EridaniBrew/BrewSpinDome/Documentation/ScopeImages/Rotation Wiring/IMG_0878.JPG

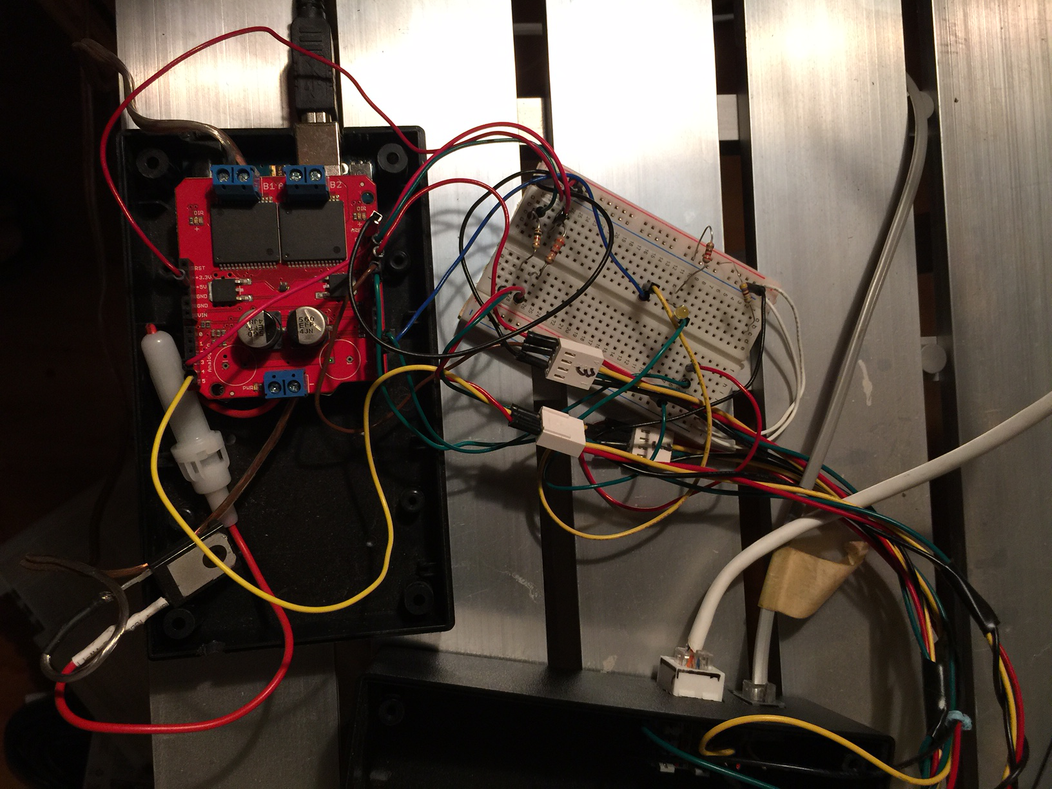
Documentation/ScopeImages/Rotation Wiring/IMG_0878.JPG
