EridaniBrew/BrewSpinDome/Documentation/ScopeImages/Rotation Wiring/IMG_0879.JPG

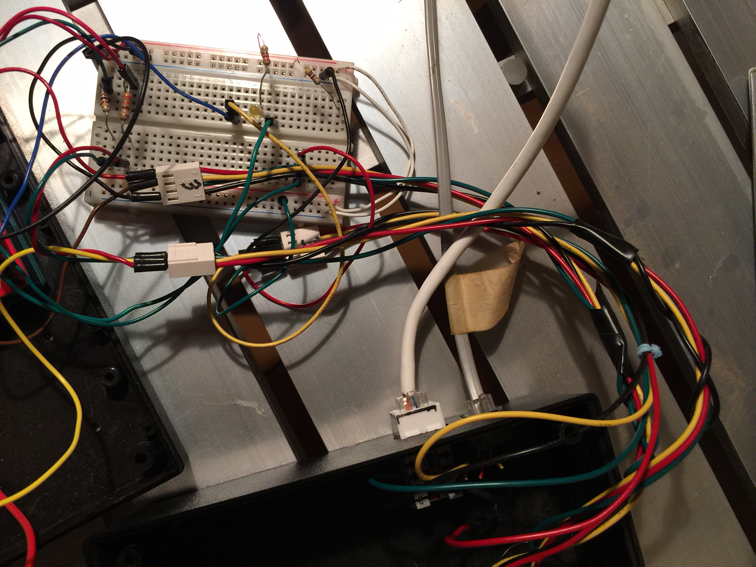
Documentation/ScopeImages/Rotation Wiring/IMG_0879.JPG
