EridaniBrew/BrewSpinDome/README.md

# BrewSpinDome
ASCOM SpinDome driver for Foster replacement system
