EridaniBrew/BrewSpinDome/ArduinoShutterControl/ShutterControlCover.jpg

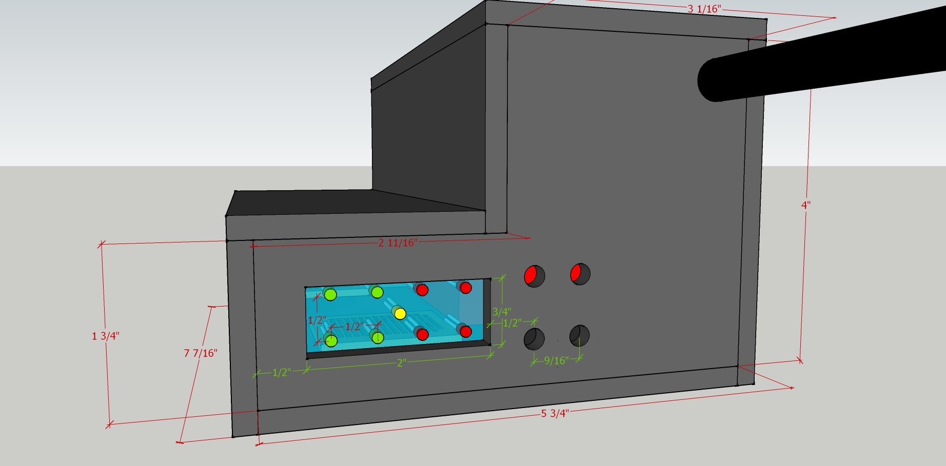
ArduinoShutterControl/ShutterControlCover.jpg
