EridaniBrew/BrewSpinDome/ArduinoShutterControl/ShutterControlSide1.jpg

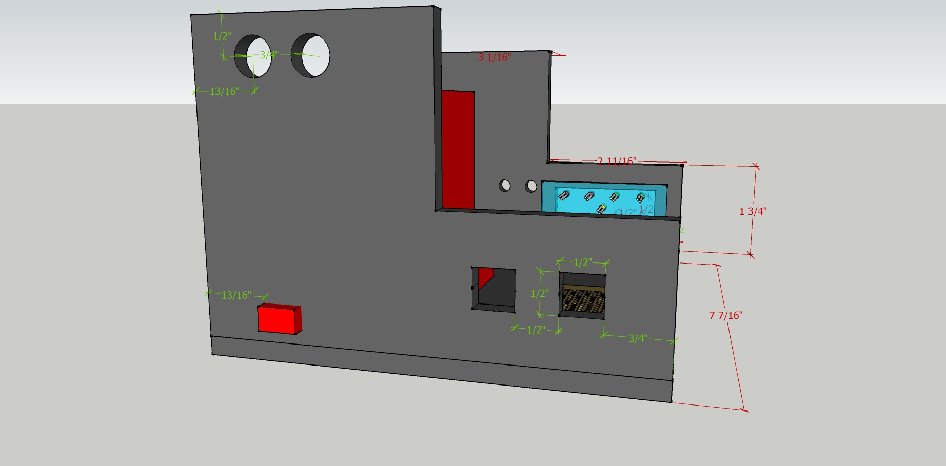
ArduinoShutterControl/ShutterControlSide1.jpg
