EridaniBrew/BrewSpinDome/ArduinoShutterControl/ShutterControlSide2.jpg

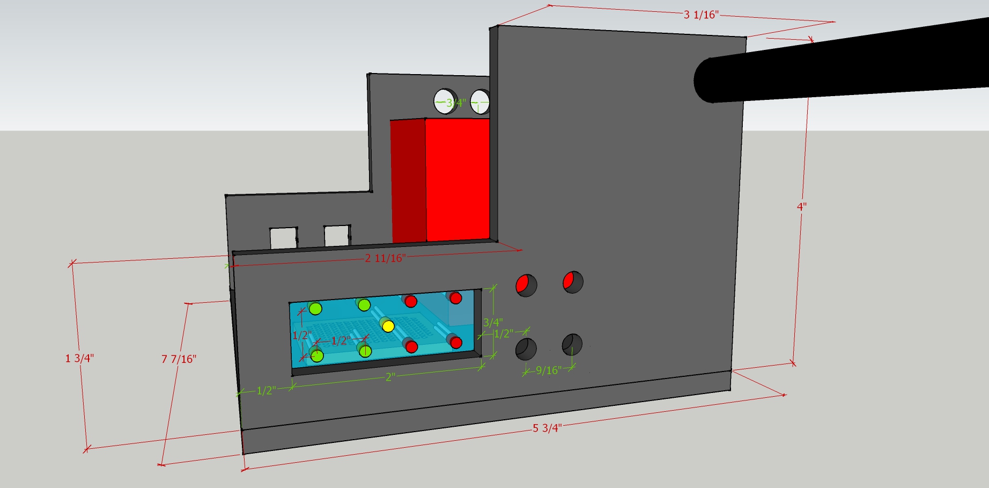
ArduinoShutterControl/ShutterControlSide2.jpg
