EridaniBrew/BrewSpinDome/ArduinoShutterControl/SmallPCB.png

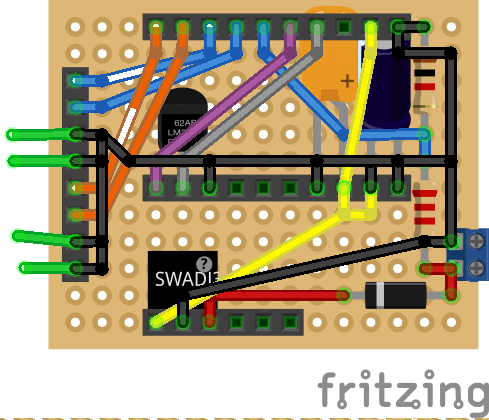
ArduinoShutterControl/SmallPCB.png
