EridaniBrew/BrewSpinDome/BrewSpinDome/BrewSpinControl/Resources/animdome.gif

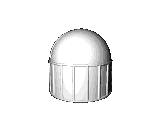
BrewSpinDome/BrewSpinControl/Resources/animdome.gif
