EridaniBrew/BrewSpinDome/BrewSpinDome/BrewSpinControl/Resources/blueLightOn.png

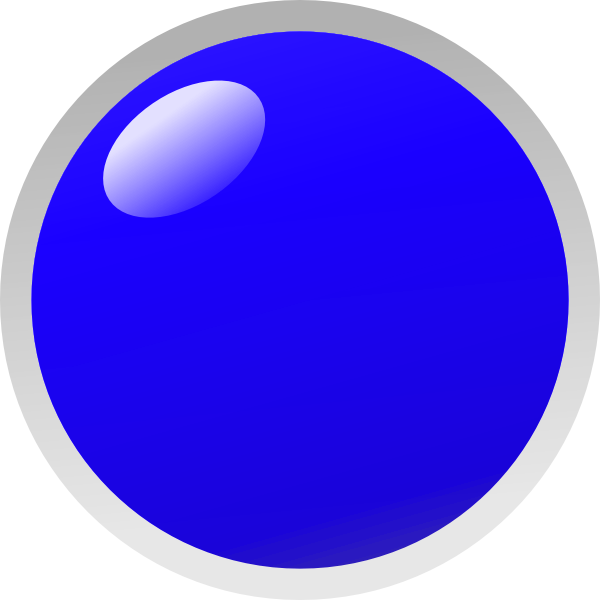
BrewSpinDome/BrewSpinControl/Resources/blueLightOn.png
