EridaniBrew/BrewSpinDome/BrewSpinDome/BrewSpinControl/Resources/Closed.png

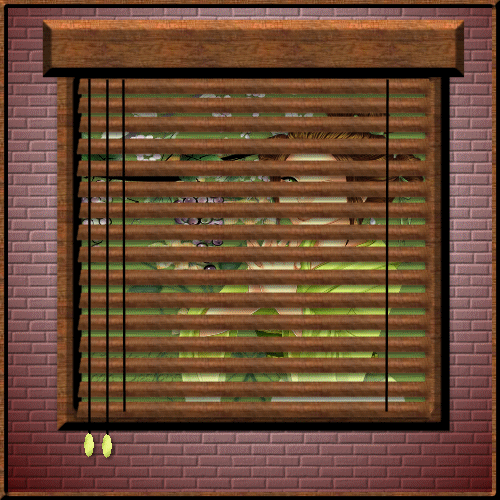
BrewSpinDome/BrewSpinControl/Resources/Closed.png
