EridaniBrew/BrewSpinDome/BrewSpinDome/BrewSpinControl/Resources/Closing.gif

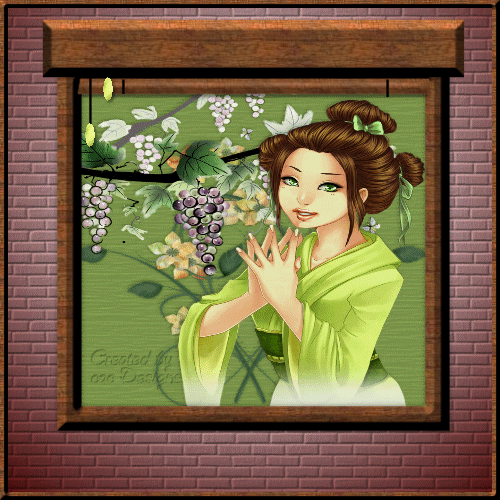
BrewSpinDome/BrewSpinControl/Resources/Closing.gif
