EridaniBrew/BrewSpinDome/BrewSpinDome/BrewSpinControl/Resources/loudlightning.gif

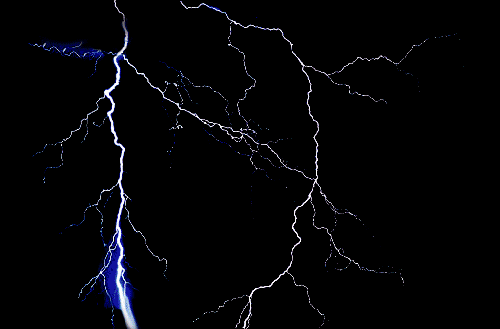
BrewSpinDome/BrewSpinControl/Resources/loudlightning.gif
