EridaniBrew/BrewSpinDome/BrewSpinDome/BrewSpinControl/Resources/quick.gif

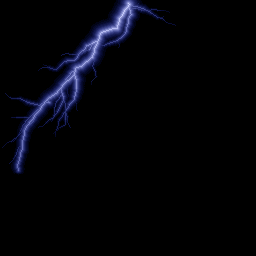
BrewSpinDome/BrewSpinControl/Resources/quick.gif
