EridaniBrew/BrewSpinDome/BrewSpinDome/BrewSpinControl/Resources/yellowLightOn.png

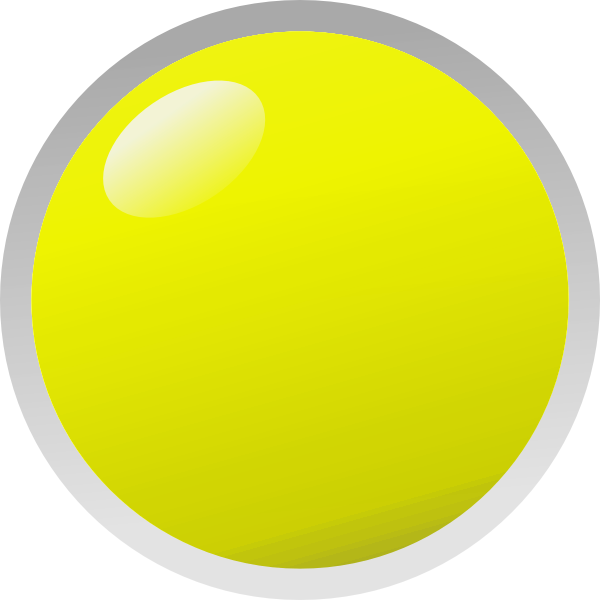
BrewSpinDome/BrewSpinControl/Resources/yellowLightOn.png
