EridaniBrew/BrewSpinDome/BrewSpinDome/SimpleShutter/Doc/Ard1.jpg

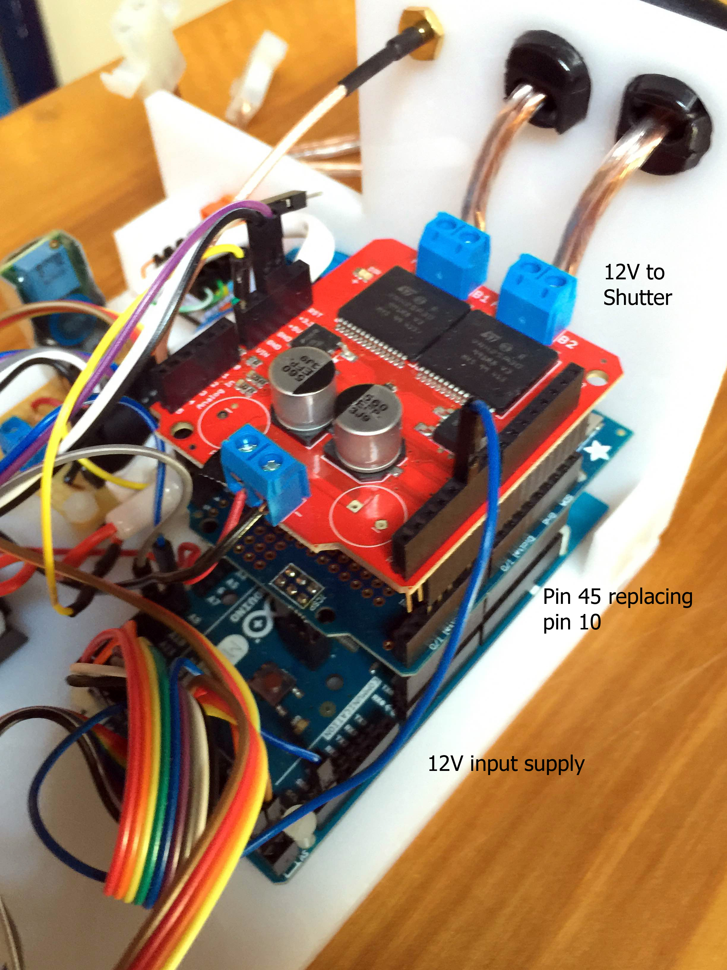
BrewSpinDome/SimpleShutter/Doc/Ard1.jpg
