EridaniBrew/BrewSpinDome/BrewSpinDome/SimpleShutter/Doc/DomeMount.jpg

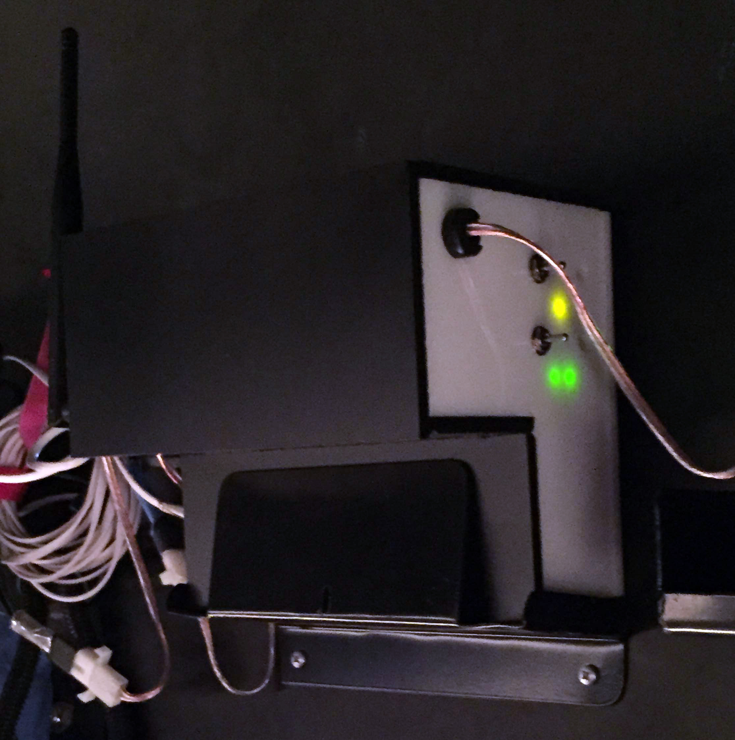
BrewSpinDome/SimpleShutter/Doc/DomeMount.jpg
