EridaniBrew/BrewSpinDome/BrewSpinDome/SimpleShutter/Doc/IMG_0030.JPG

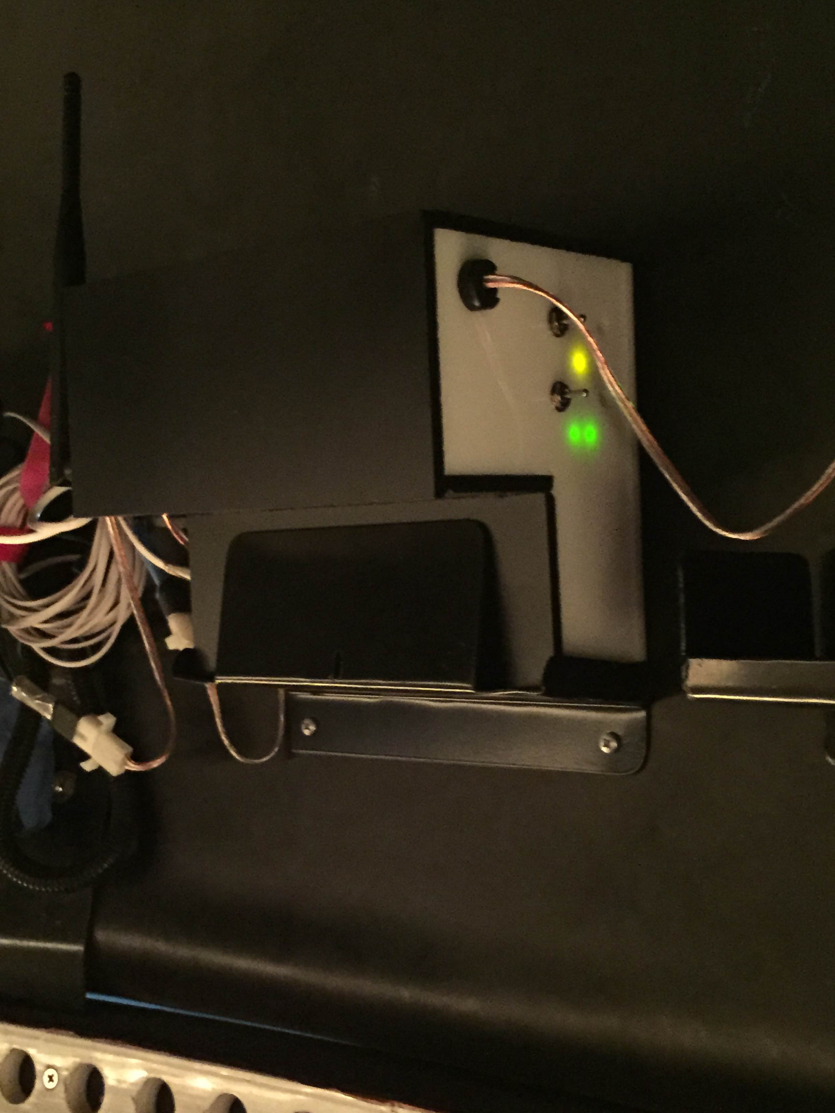
BrewSpinDome/SimpleShutter/Doc/IMG_0030.JPG
