EridaniBrew/BrewSpinDome/BrewSpinDome/SimpleShutter/Doc/IMG_0031.JPG

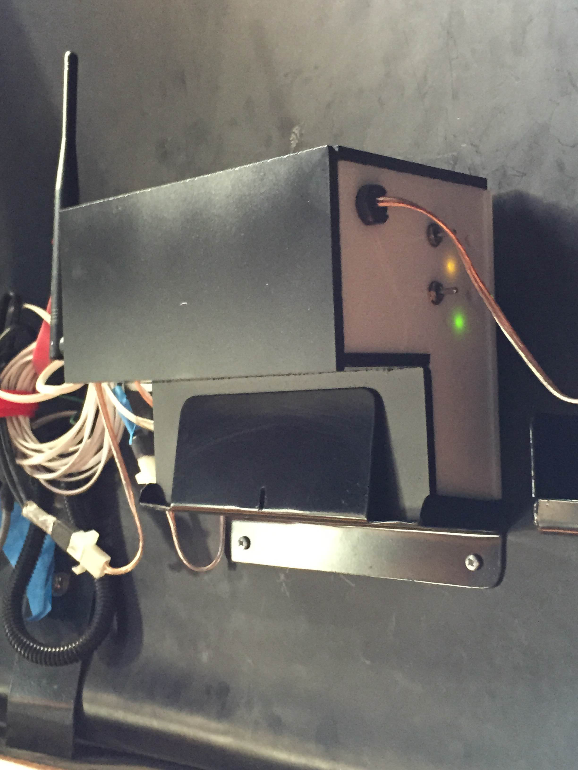
BrewSpinDome/SimpleShutter/Doc/IMG_0031.JPG
