EridaniBrew/BrewSpinDome/BrewSpinDome/SimpleShutter/Doc/IMG_0032.JPG

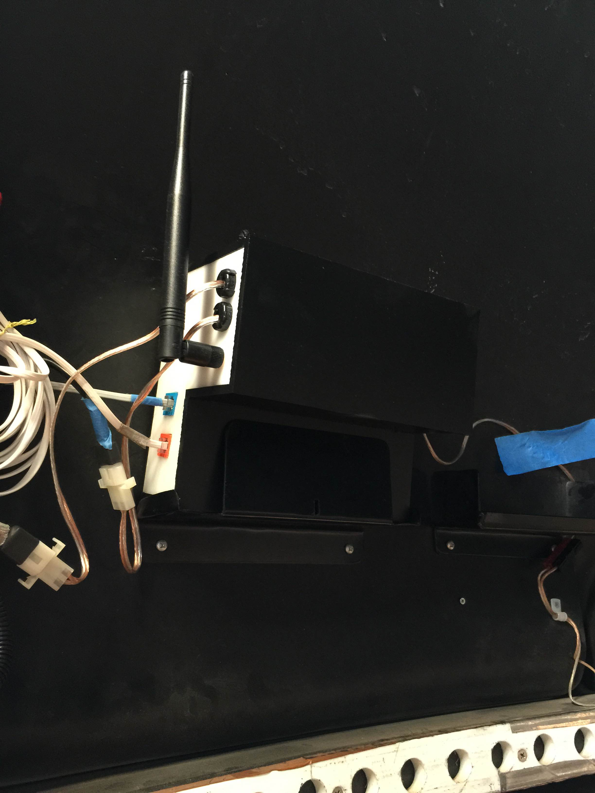
BrewSpinDome/SimpleShutter/Doc/IMG_0032.JPG
