EridaniBrew/BrewSpinDome/BrewSpinDome/SimpleShutter/Doc/IMG_0033.JPG

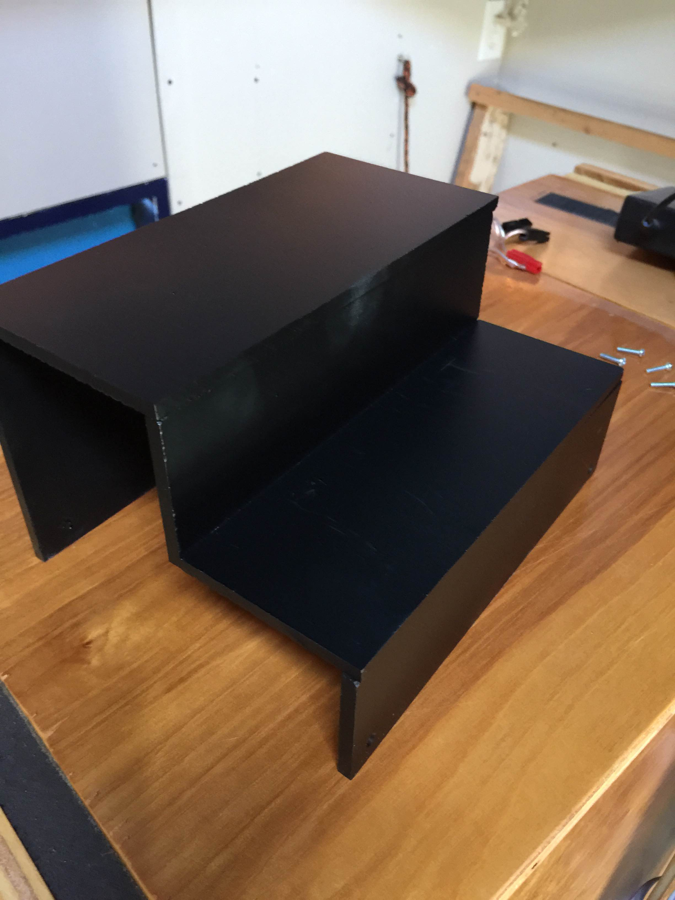
BrewSpinDome/SimpleShutter/Doc/IMG_0033.JPG
