EridaniBrew/BrewSpinDome/BrewSpinDome/SimpleShutter/Doc/IMG_0034.JPG

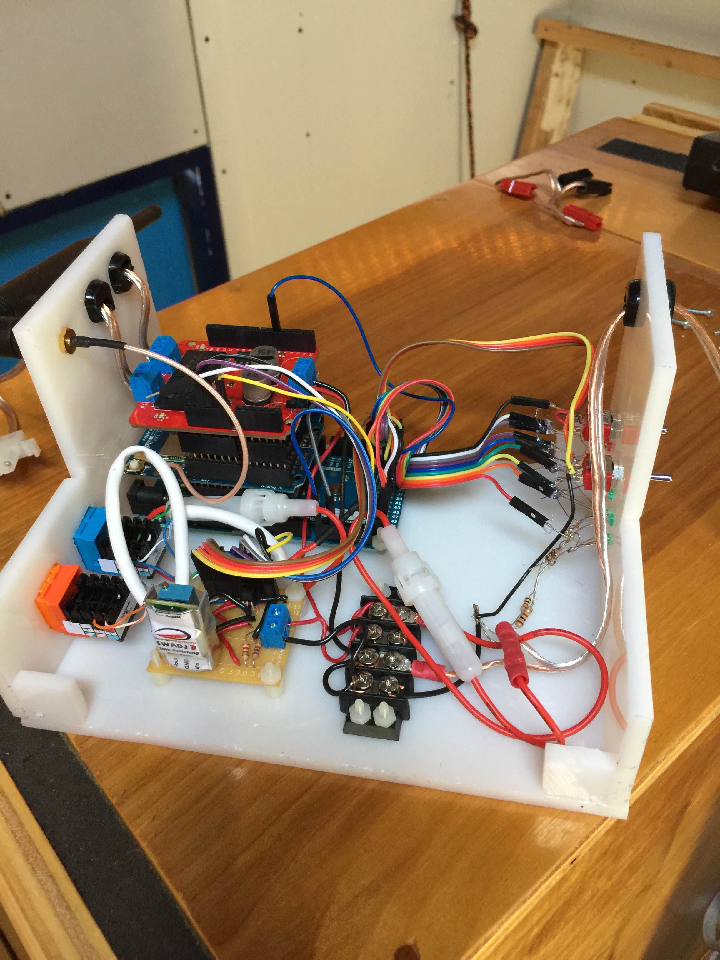
BrewSpinDome/SimpleShutter/Doc/IMG_0034.JPG
