EridaniBrew/BrewSpinDome/BrewSpinDome/SimpleShutter/Doc/IMG_0035.JPG

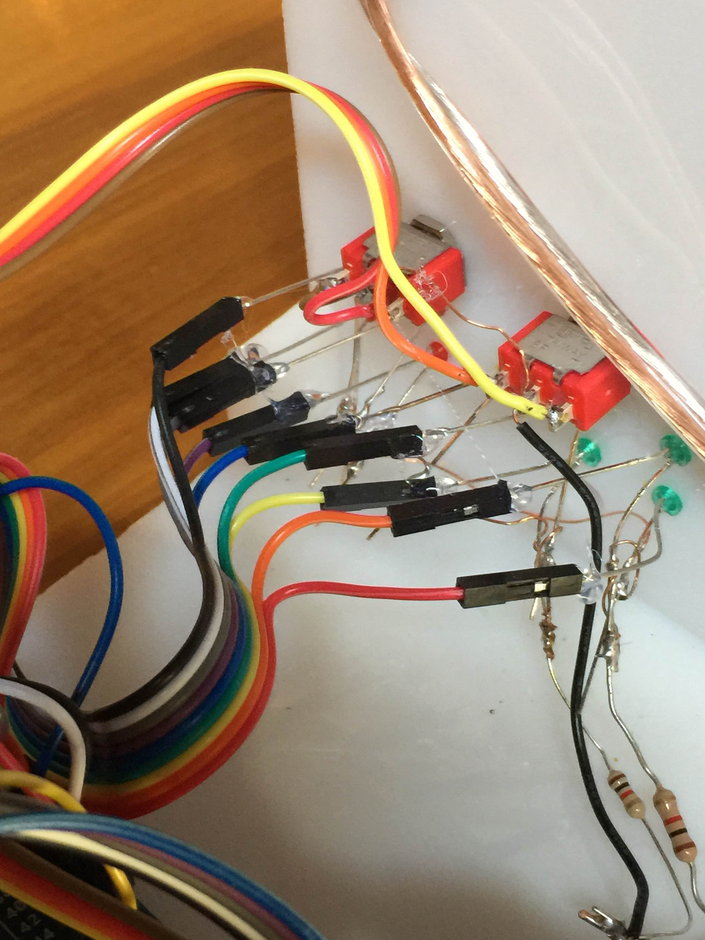
BrewSpinDome/SimpleShutter/Doc/IMG_0035.JPG
