EridaniBrew/BrewSpinDome/BrewSpinDome/SimpleShutter/Doc/IMG_0036.JPG

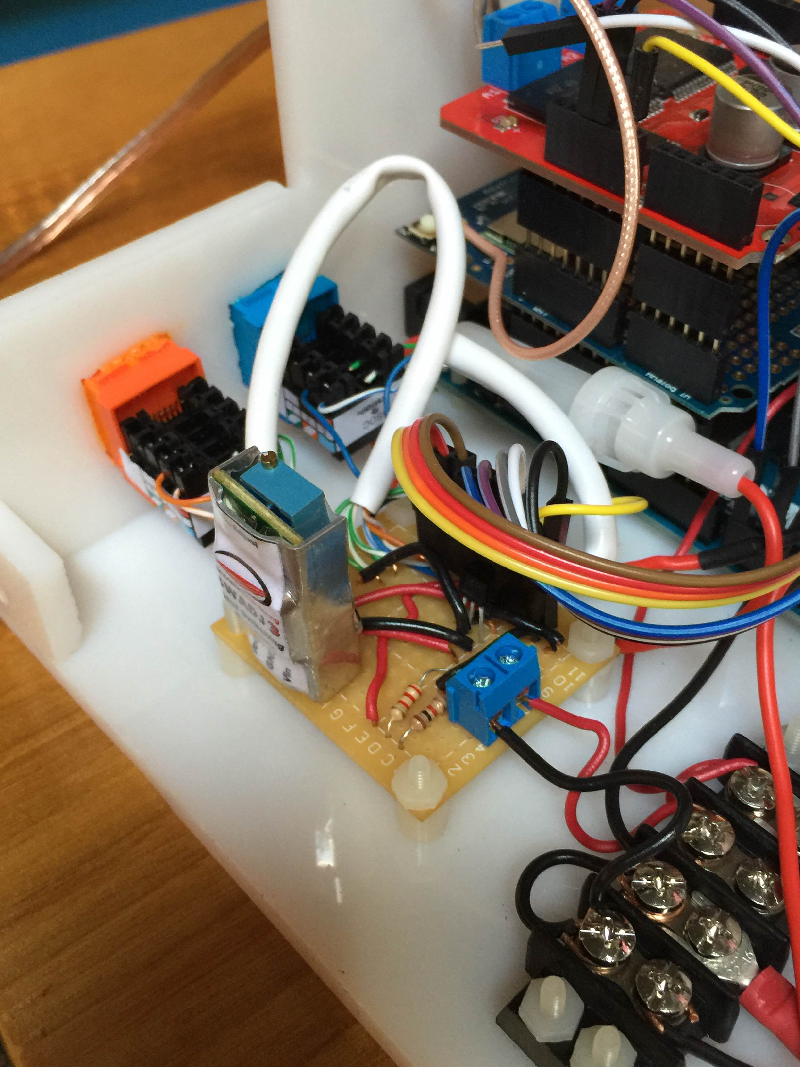
BrewSpinDome/SimpleShutter/Doc/IMG_0036.JPG
