EridaniBrew/BrewSpinDome/BrewSpinDome/SimpleShutter/Doc/IMG_0037.JPG

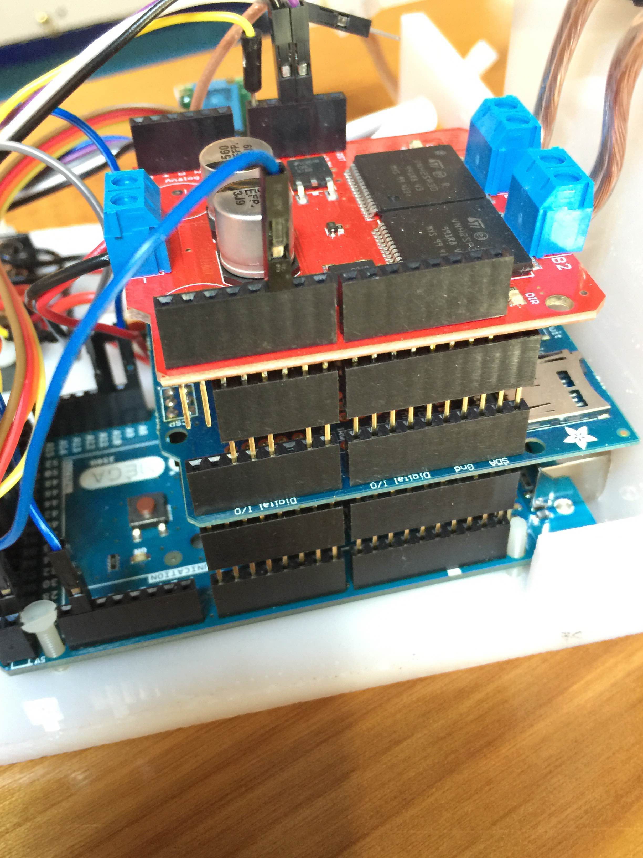
BrewSpinDome/SimpleShutter/Doc/IMG_0037.JPG
