EridaniBrew/BrewSpinDome/BrewSpinDome/SimpleShutter/Doc/SmallCircuit.jpg

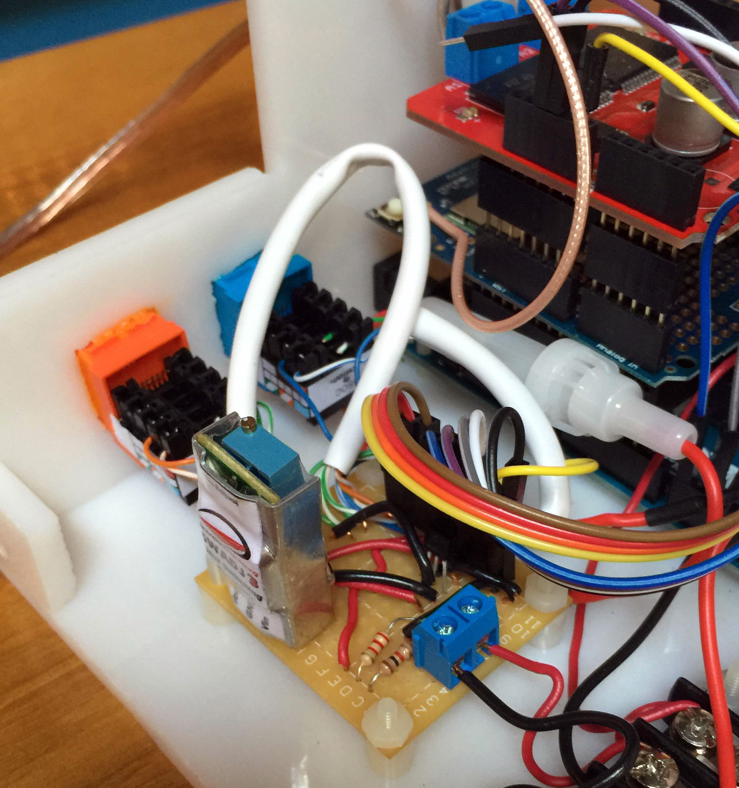
BrewSpinDome/SimpleShutter/Doc/SmallCircuit.jpg
