EridaniBrew/BrewSpinDome/BrewSpinDome/SimpleShutter/Resources/Between.png

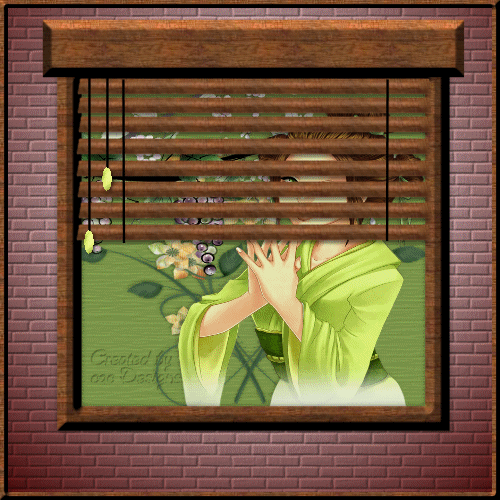
BrewSpinDome/SimpleShutter/Resources/Between.png
