EridaniBrew/BrewSpinDome/BrewSpinDome/SimpleShutter/Resources/BlueUpFrameA.png

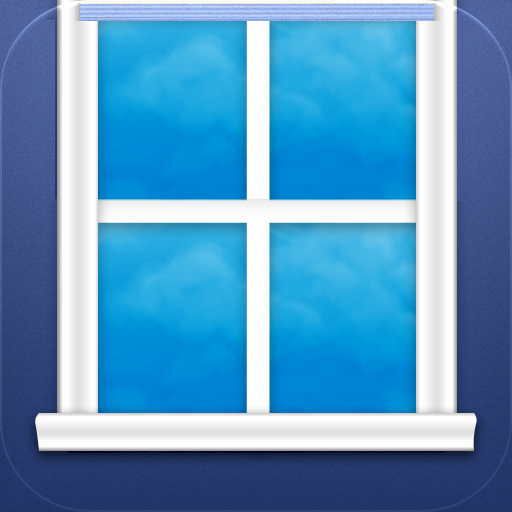
BrewSpinDome/SimpleShutter/Resources/BlueUpFrameA.png
