EridaniBrew/BrewSpinDome/BrewSpinDome/SimpleShutter/Resources/GreenDownFrame.png

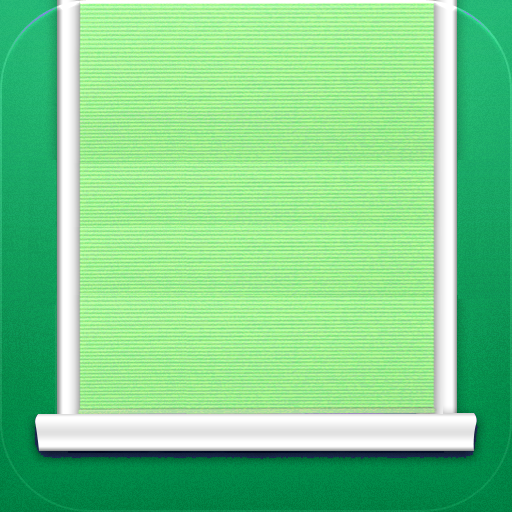
BrewSpinDome/SimpleShutter/Resources/GreenDownFrame.png
