EridaniBrew/BrewSpinDome/BrewSpinDome/SimpleShutter/Resources/YellowMidFrame.png

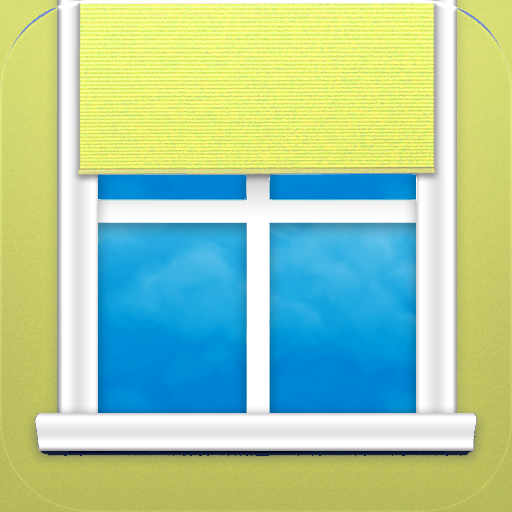
BrewSpinDome/SimpleShutter/Resources/YellowMidFrame.png
