EridaniBrew/BrewSpinDome/Documentation/ControlConfig.png

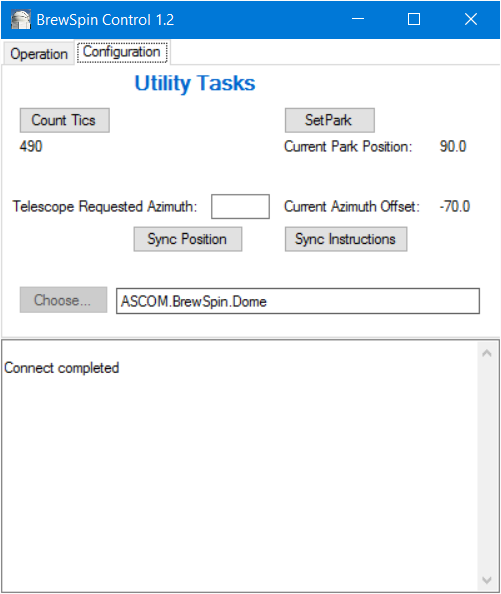
Documentation/ControlConfig.png
