EridaniBrew/BrewSpinDome/Documentation/ControlMain.png

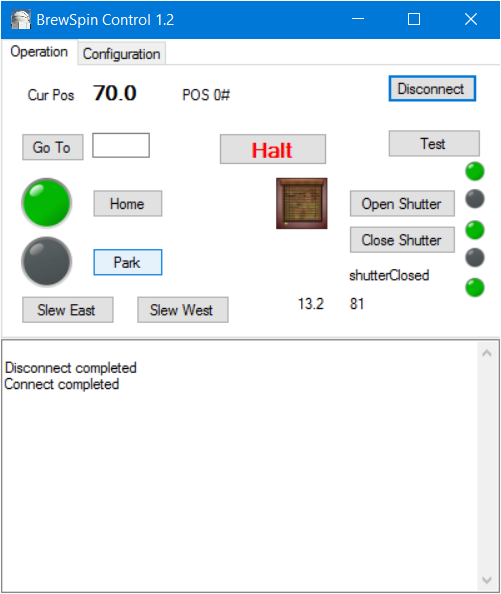
Documentation/ControlMain.png
