EridaniBrew/BrewSpinDome/Documentation/IRReflectiveSensor2349.png

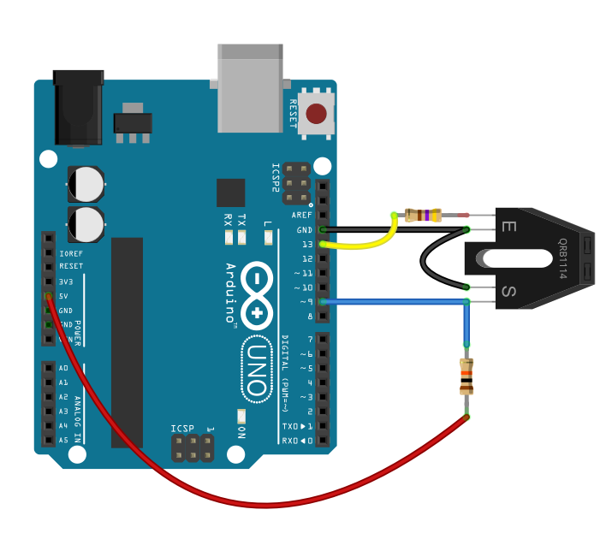
Documentation/IRReflectiveSensor2349.png
