EridaniBrew/BrewSpinDome/Documentation/Mark I Sensor/MarkIBracket.JPG

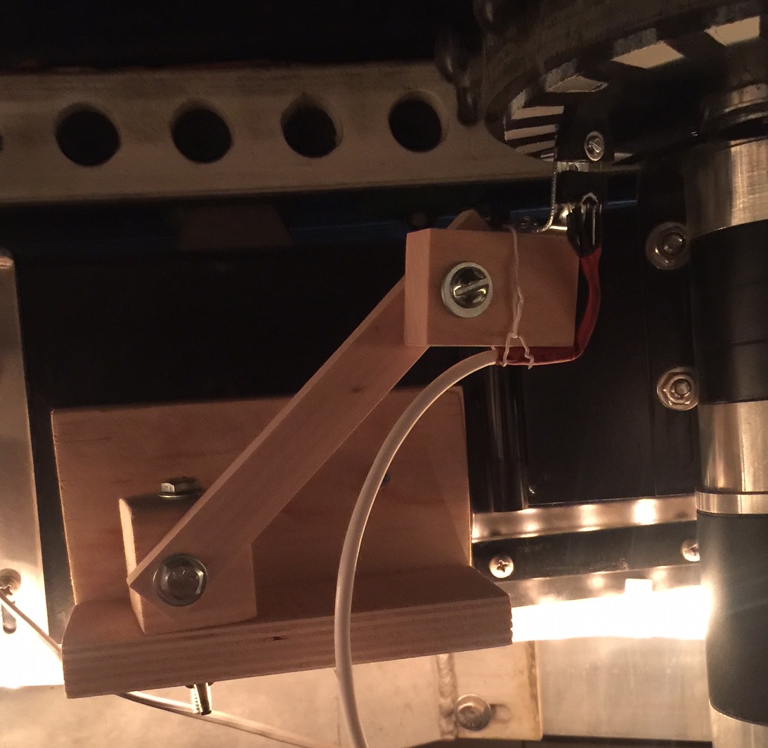
Documentation/Mark I Sensor/MarkIBracket.JPG
