EridaniBrew/BrewSpinDome/Documentation/Mark I Sensor/MarkIGap.JPG

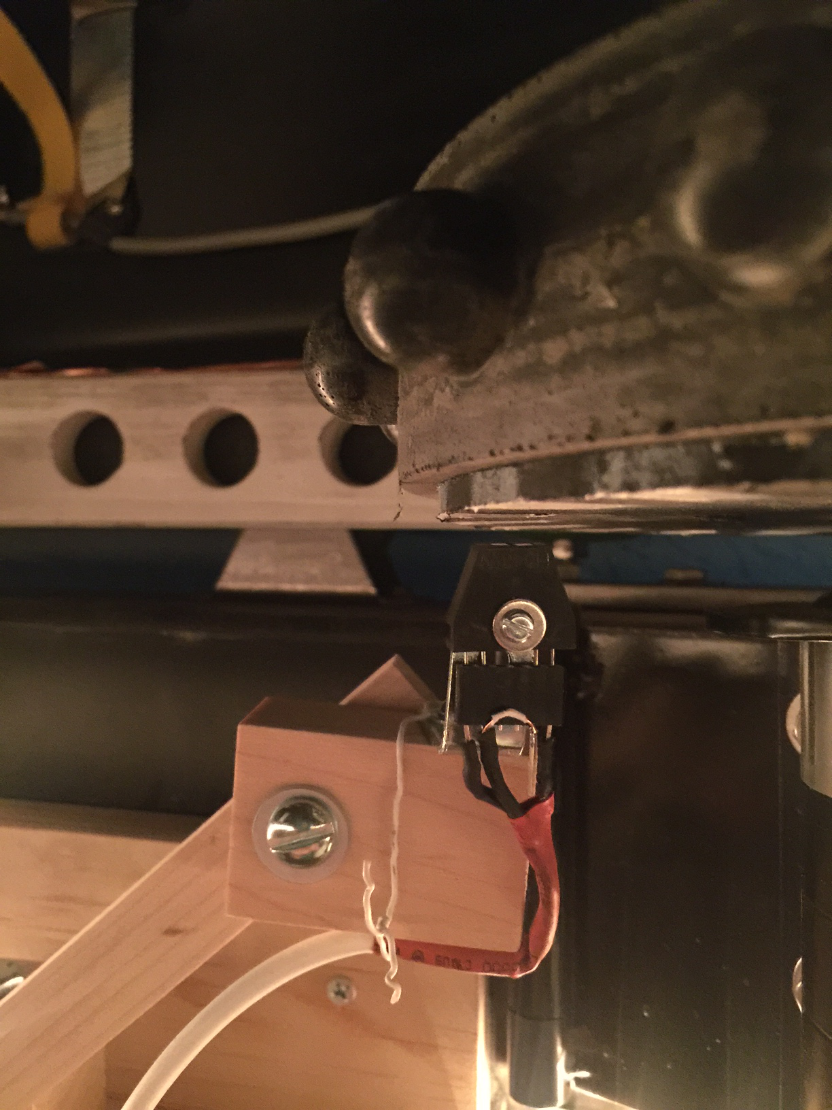
Documentation/Mark I Sensor/MarkIGap.JPG
