EridaniBrew/BrewSpinDome/Documentation/Mark I Sensor/MarkIWheel.JPG

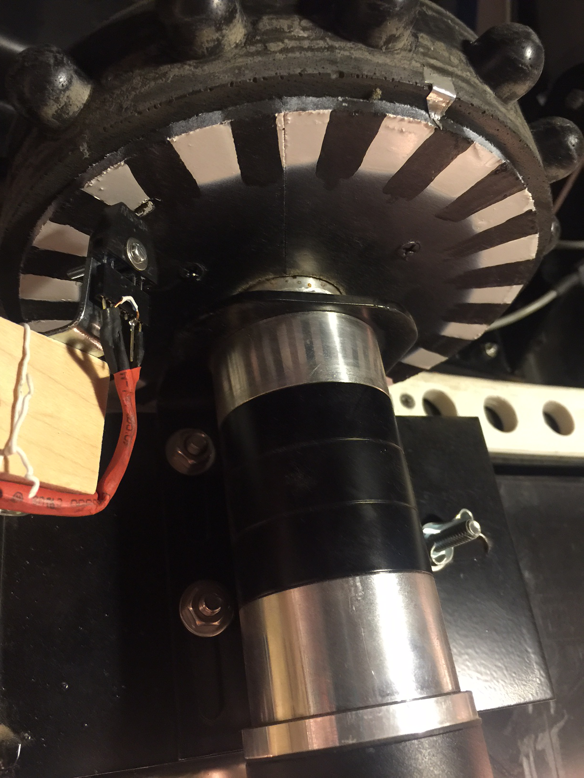
Documentation/Mark I Sensor/MarkIWheel.JPG
