EridaniBrew/BrewSpinDome/Documentation/MarkIISensor/MarkIIBracket.JPG

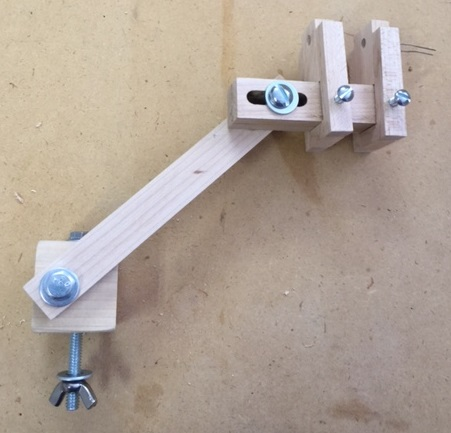
Documentation/MarkIISensor/MarkIIBracket.JPG
