EridaniBrew/BrewSpinDome/Documentation/MarkIISensor/MarkIIPail.JPG

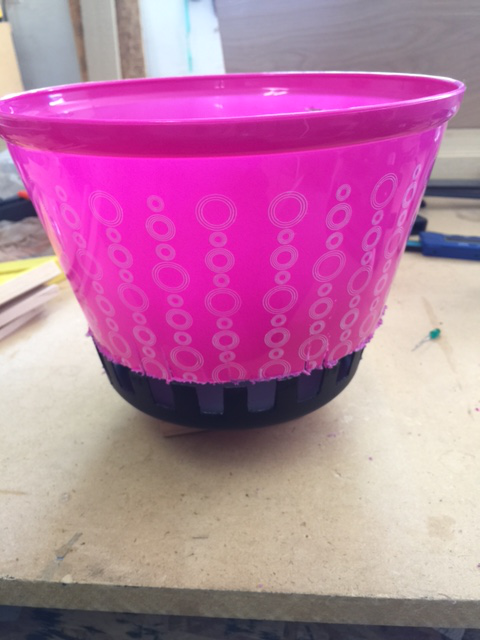
Documentation/MarkIISensor/MarkIIPail.JPG
