EridaniBrew/BrewSpinDome/Documentation/MarkIISensor/MarkIIWheelA.JPG

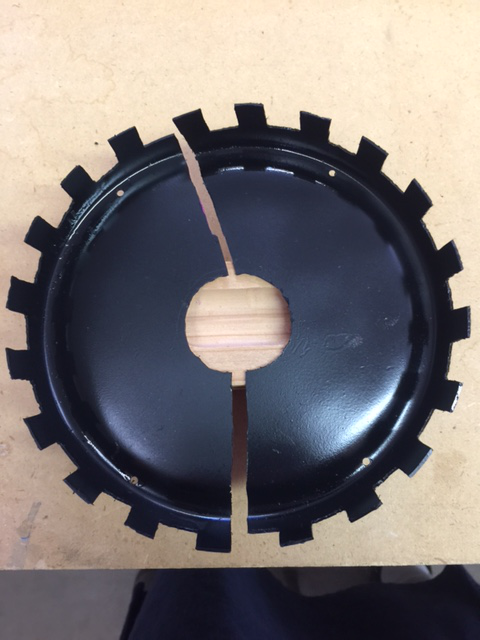
Documentation/MarkIISensor/MarkIIWheelA.JPG
