EridaniBrew/BrewSpinDome/Documentation/MarkIISensor/MarkIIWheelB.JPG

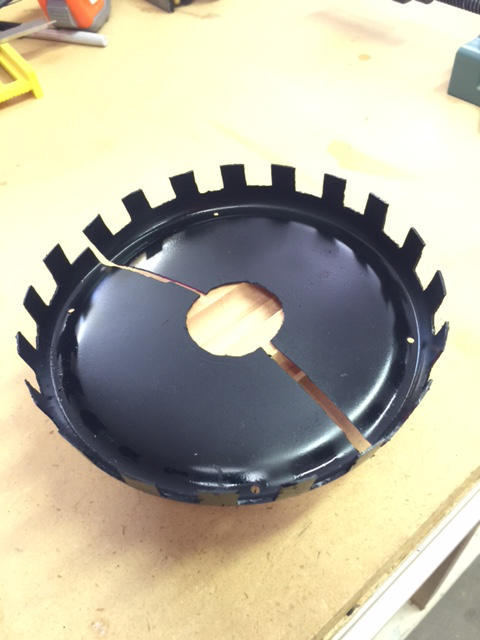
Documentation/MarkIISensor/MarkIIWheelB.JPG
