EridaniBrew/BrewSpinDome/Documentation/MarkIISensor/opAmpNonInvert.gif

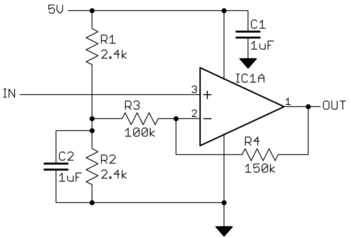
Documentation/MarkIISensor/opAmpNonInvert.gif
