EridaniBrew/BrewSpinDome/Documentation/MarkIISensor/SchmittTrigger2.jpg

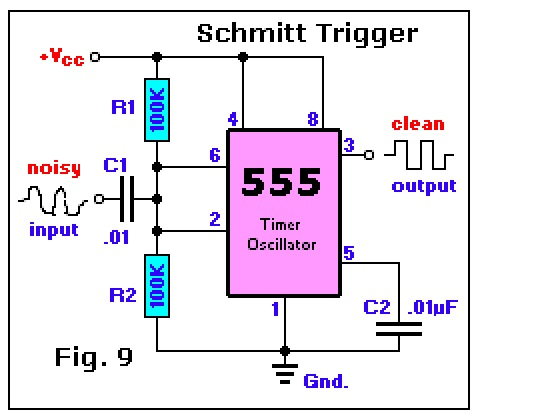
Documentation/MarkIISensor/SchmittTrigger2.jpg
