EridaniBrew/BrewSpinDome/Documentation/MarkIISensor/SchmittTrigger.jpg

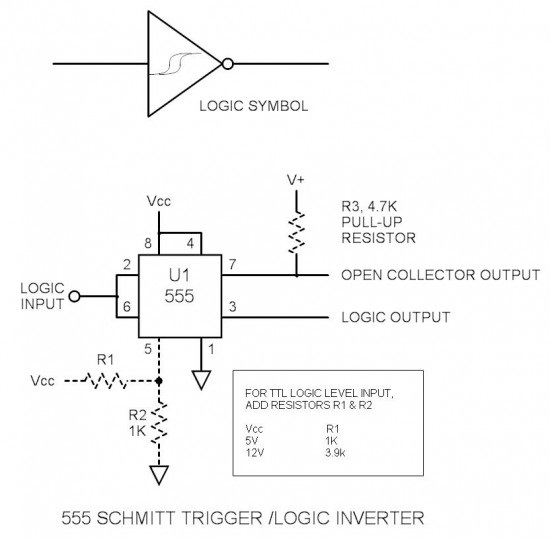
Documentation/MarkIISensor/SchmittTrigger.jpg
