EridaniBrew/BrewSpinDome/Documentation/Rotation/IMG_0882.JPG

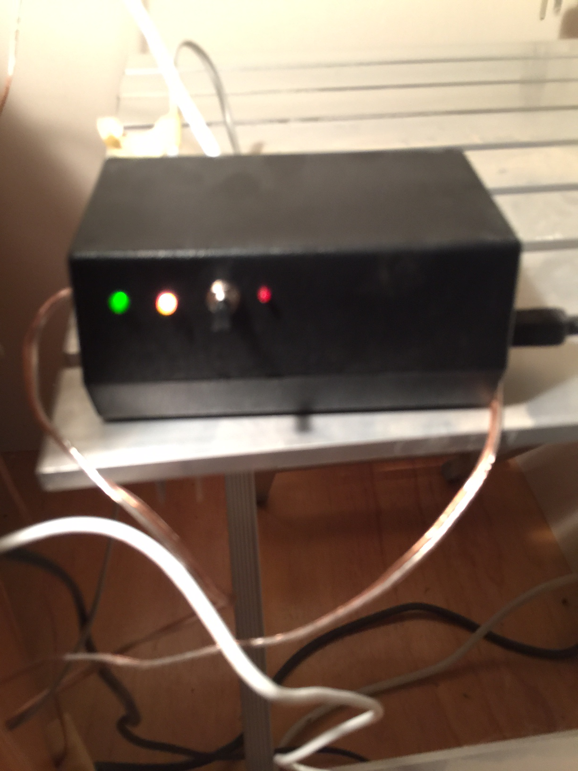
Documentation/Rotation/IMG_0882.JPG
