EridaniBrew/BrewSpinDome/Documentation/Rotation/IMG_0883.JPG

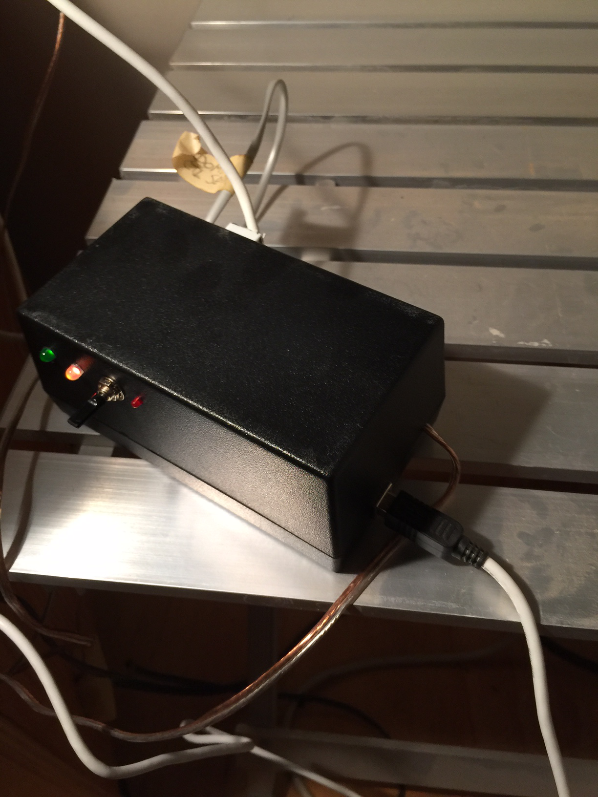
Documentation/Rotation/IMG_0883.JPG
