EridaniBrew/BrewSpinDome/Documentation/Rotation/IMG_0884.JPG

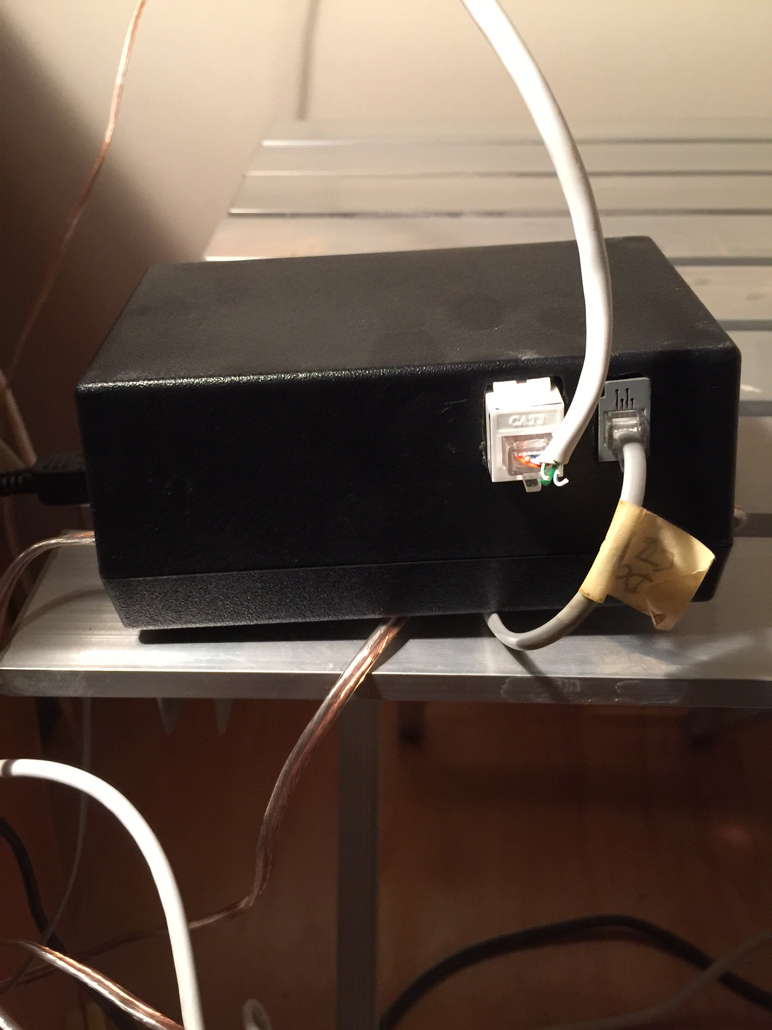
Documentation/Rotation/IMG_0884.JPG
