EridaniBrew/BrewSpinDome/Documentation/Rotation/IMG_0895.JPG

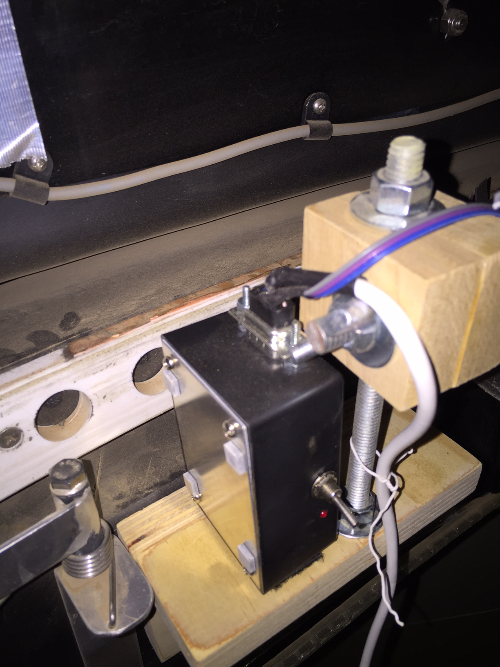
Documentation/Rotation/IMG_0895.JPG
