EridaniBrew/BrewSpinDome/Documentation/Rotation/IMG_0896.JPG

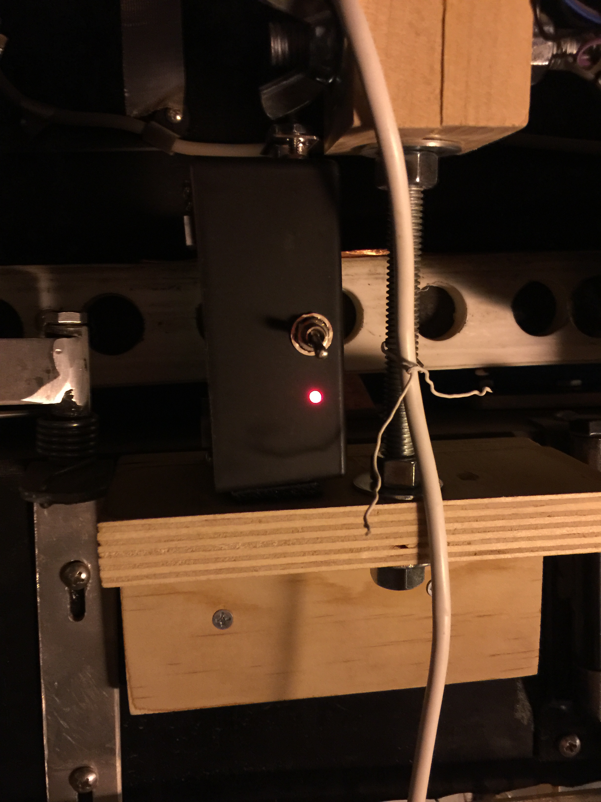
Documentation/Rotation/IMG_0896.JPG
