EridaniBrew/BrewSpinDome/Documentation/Rotation/IMG_0899.JPG

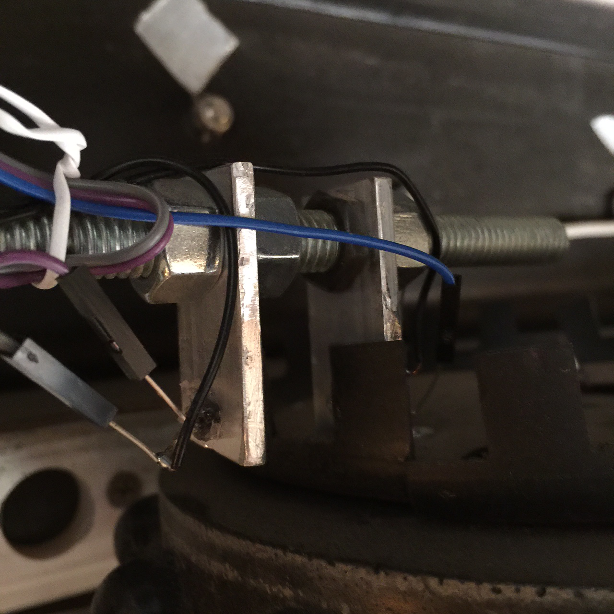
Documentation/Rotation/IMG_0899.JPG
