EridaniBrew/BrewSpinDome/Documentation/Rotation/IMG_0900.JPG

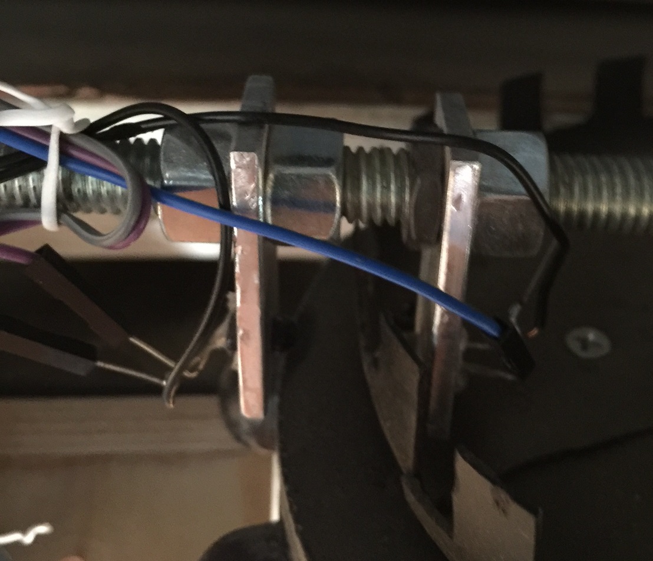
Documentation/Rotation/IMG_0900.JPG
