EridaniBrew/BrewSpinDome/Documentation/Rotation/IMG_0901.JPG

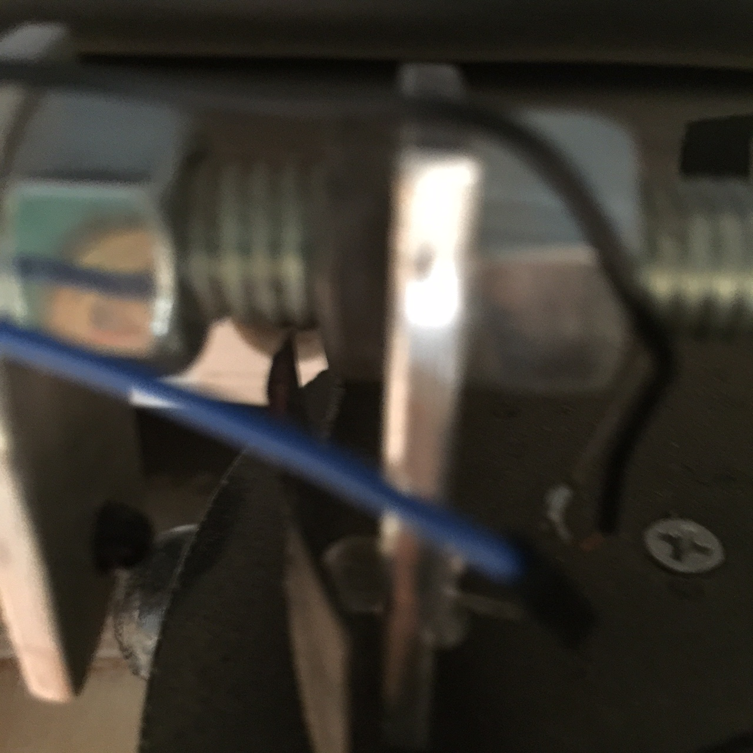
Documentation/Rotation/IMG_0901.JPG
