EridaniBrew/BrewSpinDome/Documentation/Rotation/RotationBackAnnotate.png

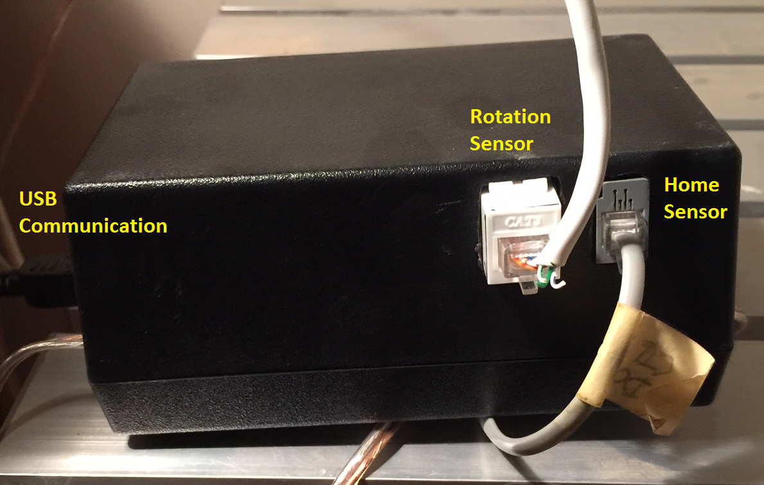
Documentation/Rotation/RotationBackAnnotate.png
