EridaniBrew/BrewSpinDome/Documentation/Rotation/RotationFront.png

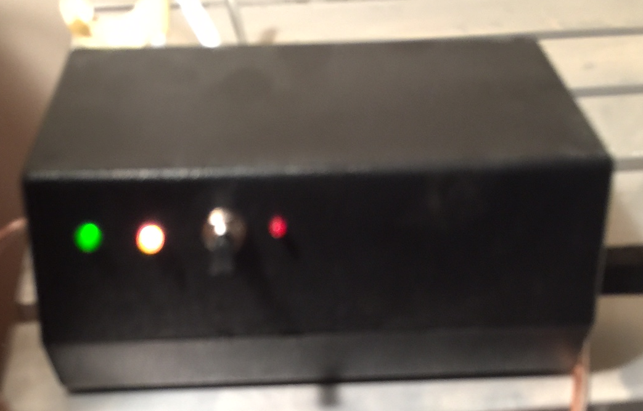
Documentation/Rotation/RotationFront.png
