EridaniBrew/BrewSpinDome/Documentation/Rotation/RotationFrontAnnotate.png

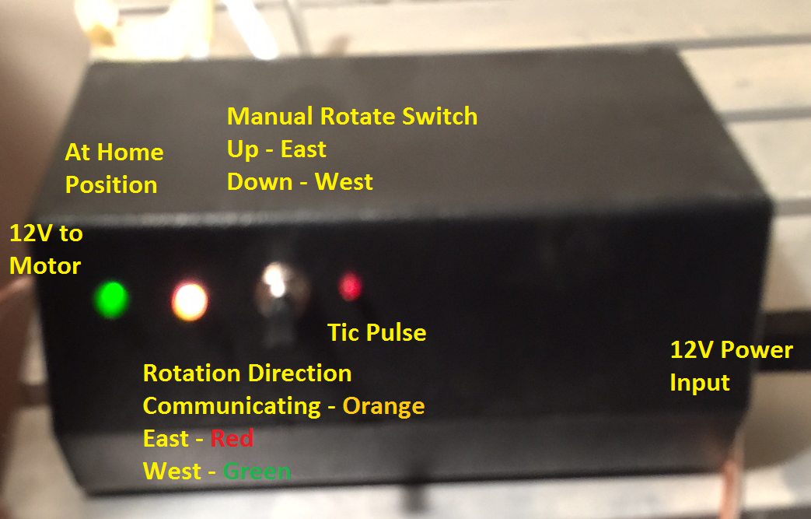
Documentation/Rotation/RotationFrontAnnotate.png
