EridaniBrew/BrewSpinDome/Documentation/Rotation/RotationSensorAnnotate.png

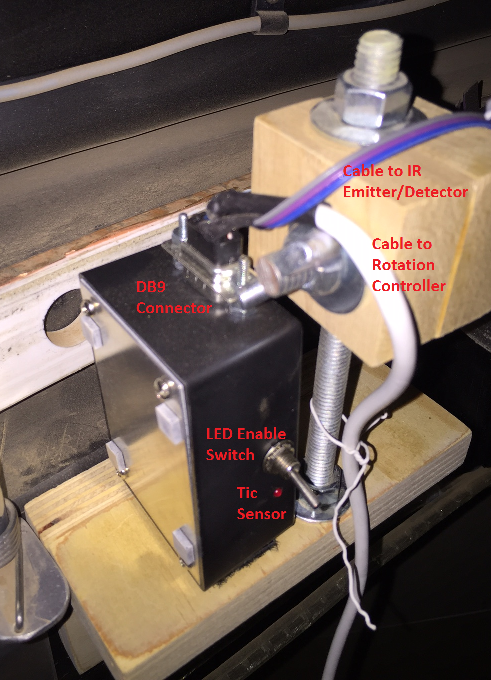
Documentation/Rotation/RotationSensorAnnotate.png
