EridaniBrew/BrewSpinDome/Documentation/ScopeImages/Interrupts/ALLBUSY.BMP

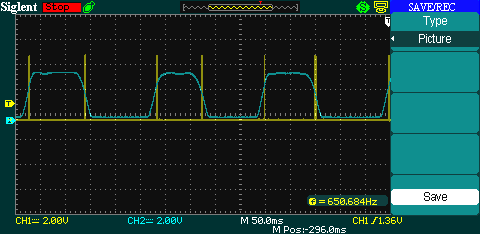
Documentation/ScopeImages/Interrupts/ALLBUSY.BMP
