EridaniBrew/BrewSpinDome/Documentation/ScopeImages/Interrupts/FEW.BMP

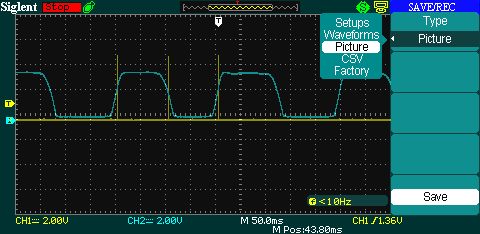
Documentation/ScopeImages/Interrupts/FEW.BMP
