EridaniBrew/BrewSpinDome/Documentation/ScopeImages/Interrupts/FEWAGAIN.BMP

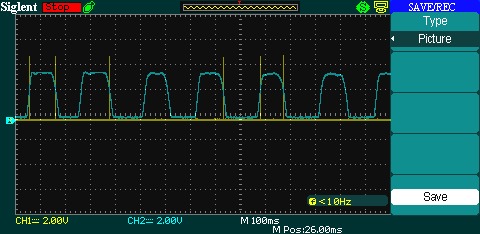
Documentation/ScopeImages/Interrupts/FEWAGAIN.BMP
