EridaniBrew/BrewSpinDome/Documentation/ScopeImages/Interrupts/GOODMAR2.BMP

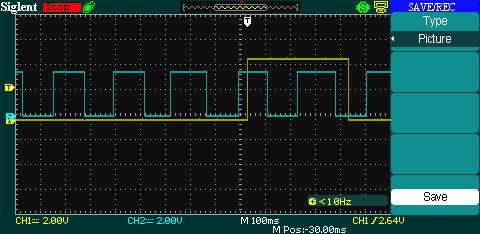
Documentation/ScopeImages/Interrupts/GOODMAR2.BMP
