EridaniBrew/BrewSpinDome/Documentation/ScopeImages/Interrupts/ZOOMMANY.BMP

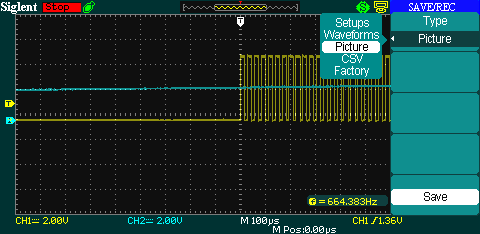
Documentation/ScopeImages/Interrupts/ZOOMMANY.BMP
