EridaniBrew/BrewSpinDome/Documentation/Shutter/IMG_0890.JPG

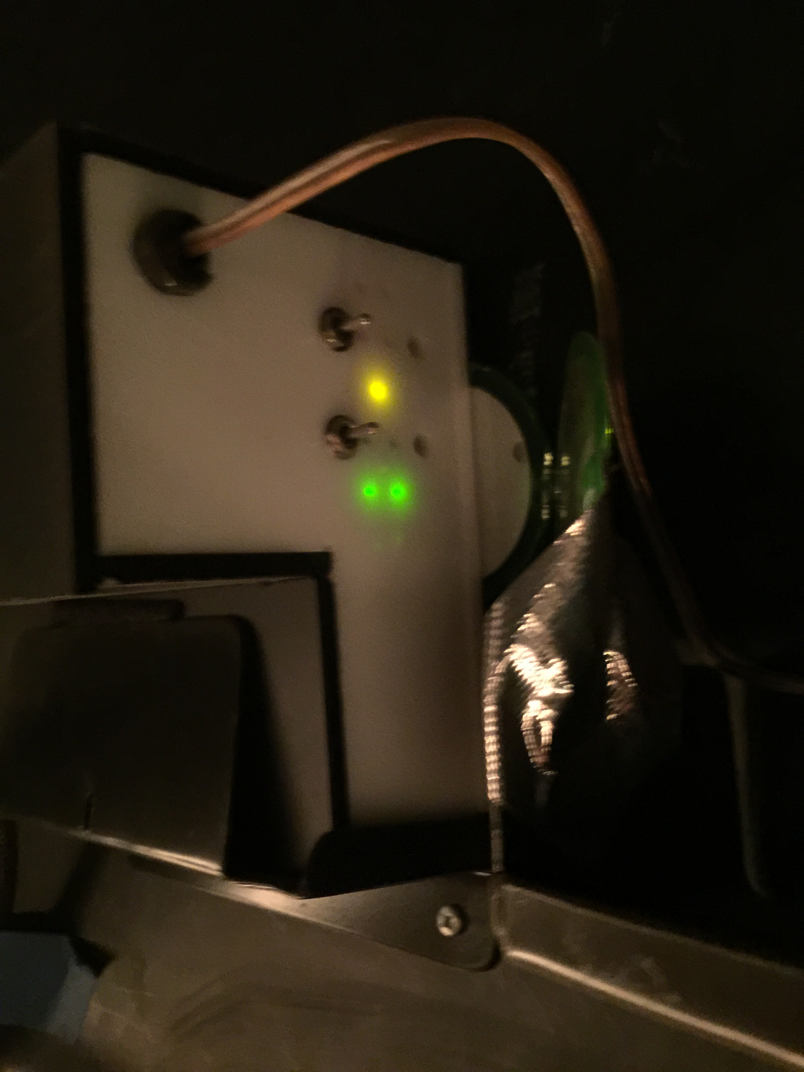
Documentation/Shutter/IMG_0890.JPG
