EridaniBrew/BrewSpinDome/Documentation/Shutter/IMG_0891.JPG

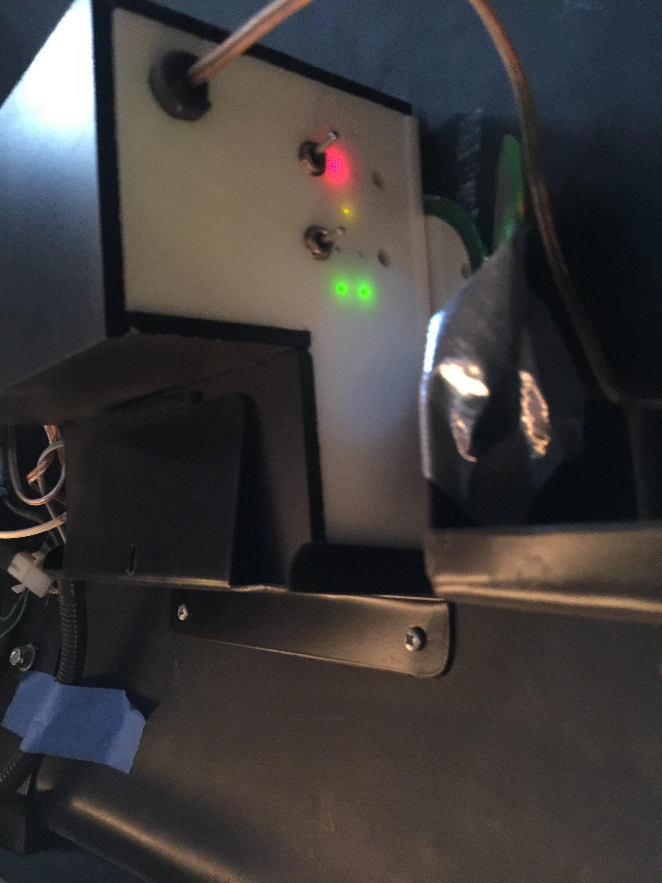
Documentation/Shutter/IMG_0891.JPG
