EridaniBrew/BrewSpinDome/Documentation/Shutter/Schematic.png

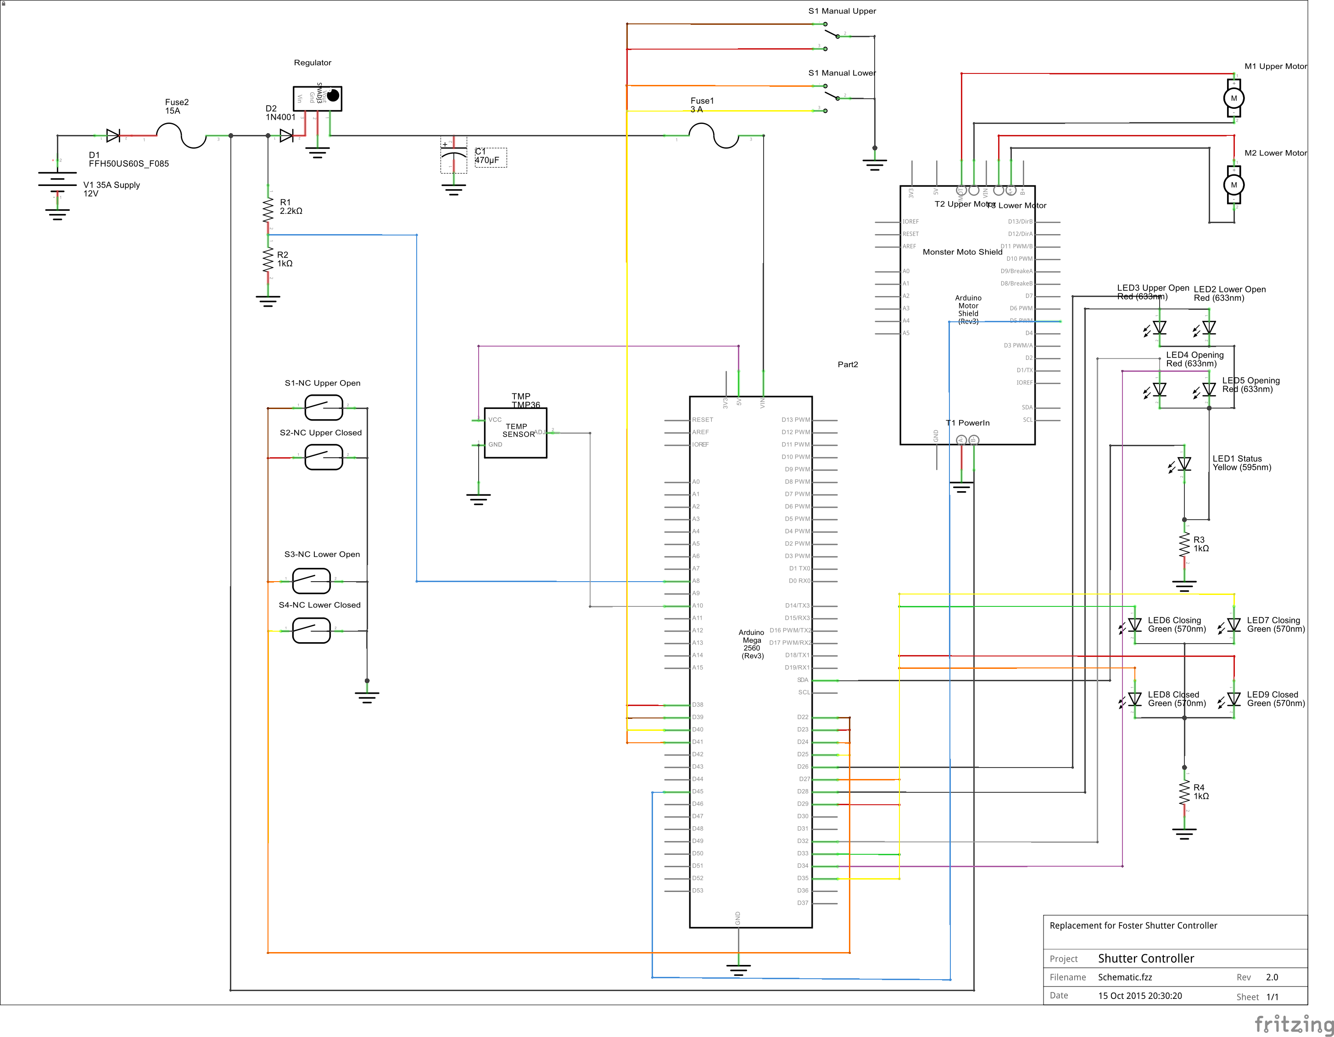
Documentation/Shutter/Schematic.png
