EridaniBrew/BrewSpinDome/Documentation/Shutter/ShellLeft.png

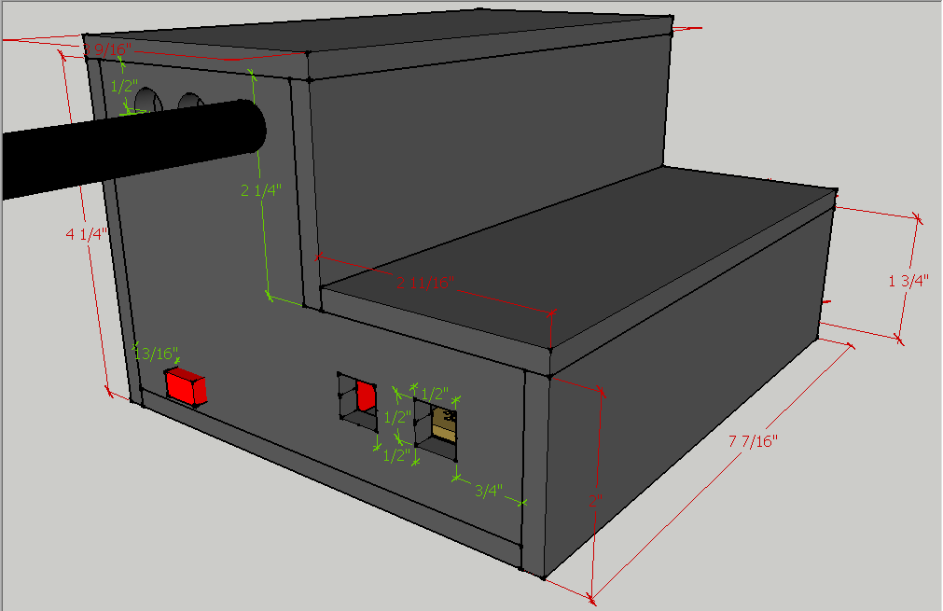
Documentation/Shutter/ShellLeft.png
