EridaniBrew/BrewSpinDome/Documentation/SpinDomeSchematic.png

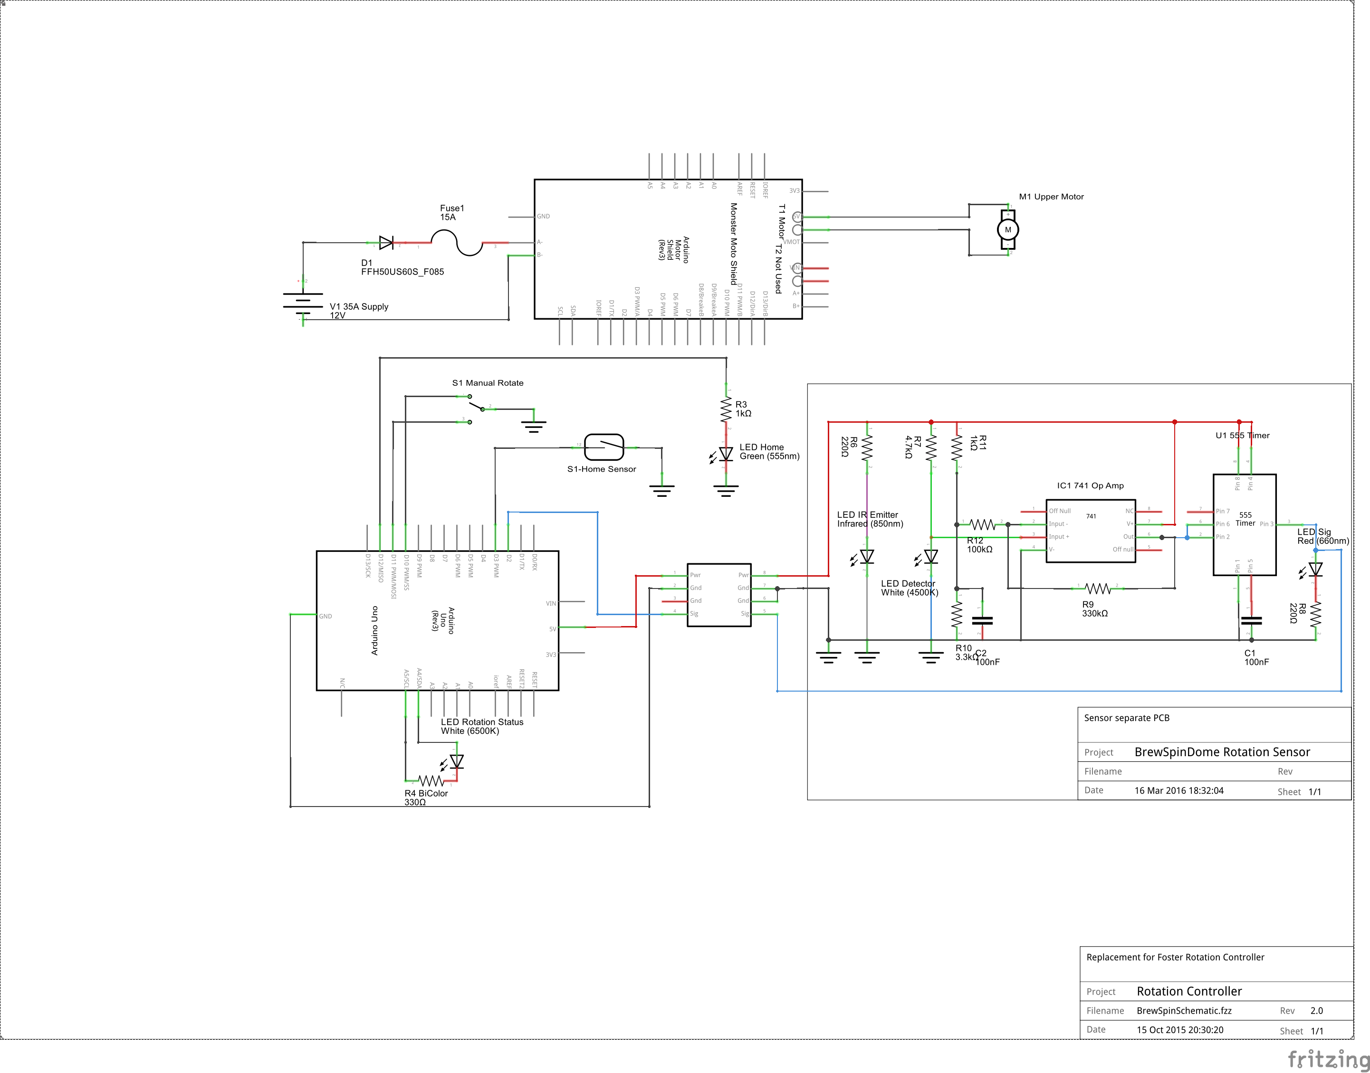
Documentation/SpinDomeSchematic.png
