EridaniBrew/BrewSpinDome/(list of files, cad)

Other CAD files:
Documentation/ControllerBox.skp
Documentation/SensorBracket.skp
