EridaniBrew/BrewSpinDome/ArduinoShutterControl/WiringSwitches.png

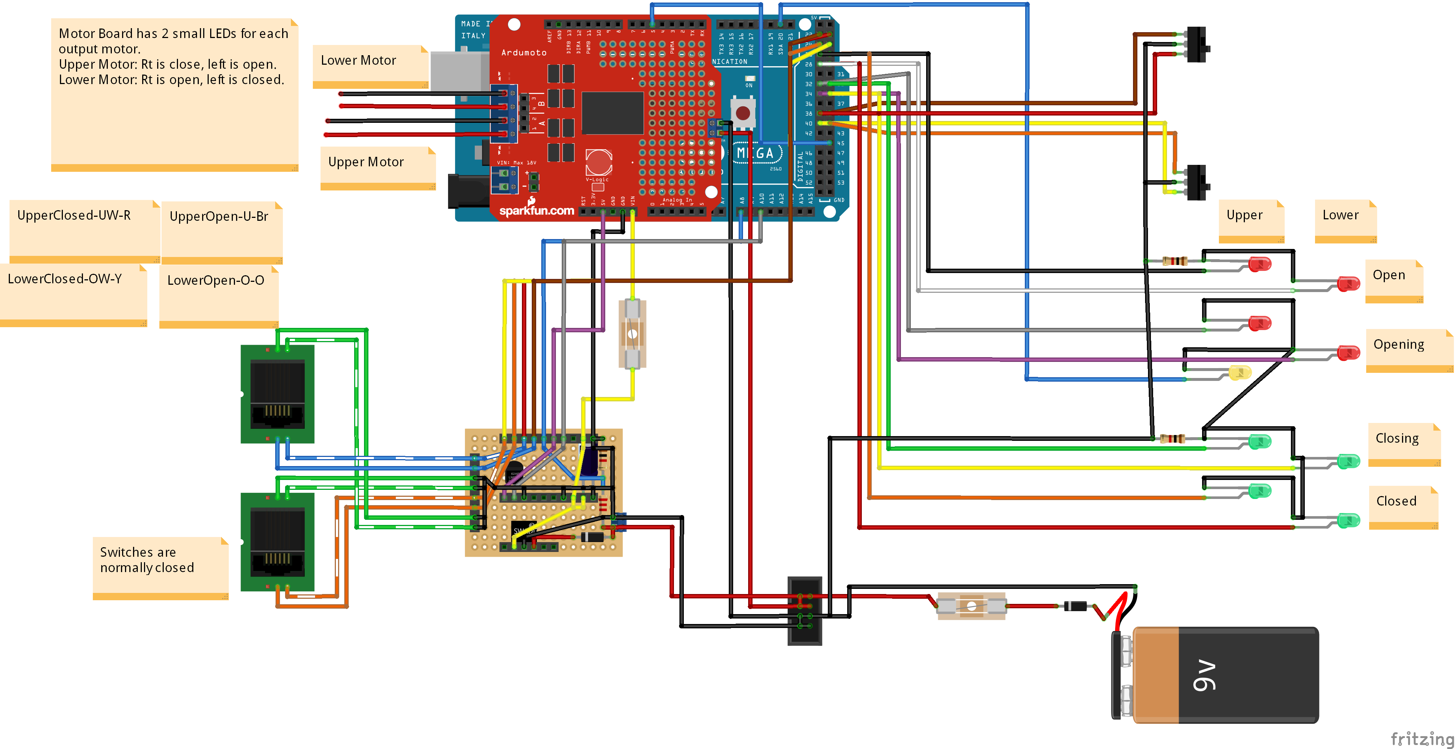
ArduinoShutterControl/WiringSwitches.png
