EridaniBrew/BrewSpinDome/Documentation/ScopeImages/Rotation Wiring/IMG_0869.JPG

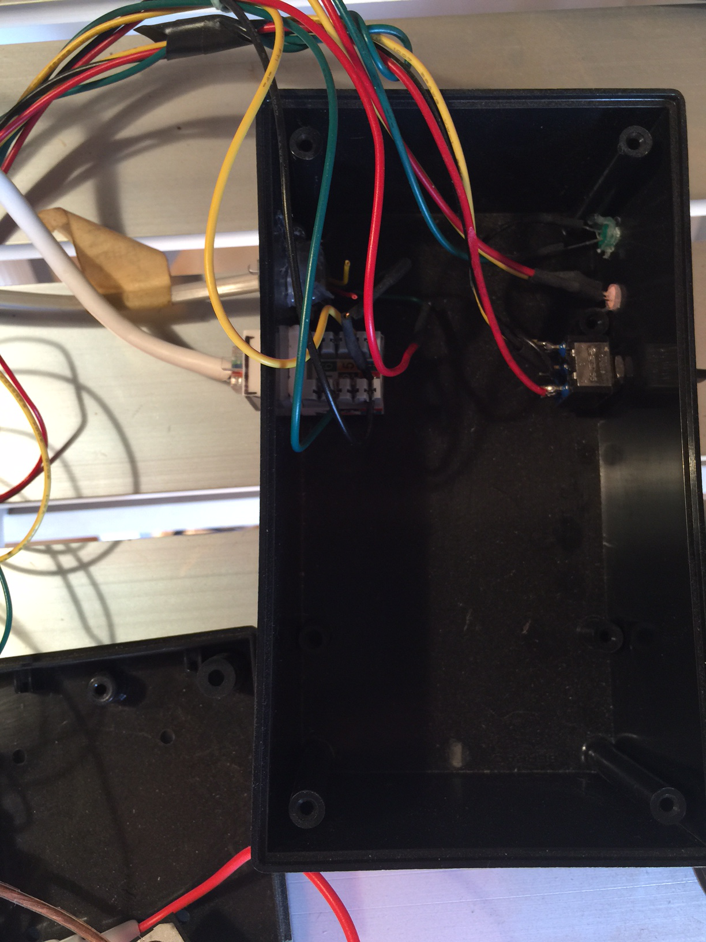
Documentation/ScopeImages/Rotation Wiring/IMG_0869.JPG
