EridaniBrew/BrewSpinDome/Documentation/ScopeImages/Rotation Wiring/IMG_0870.JPG

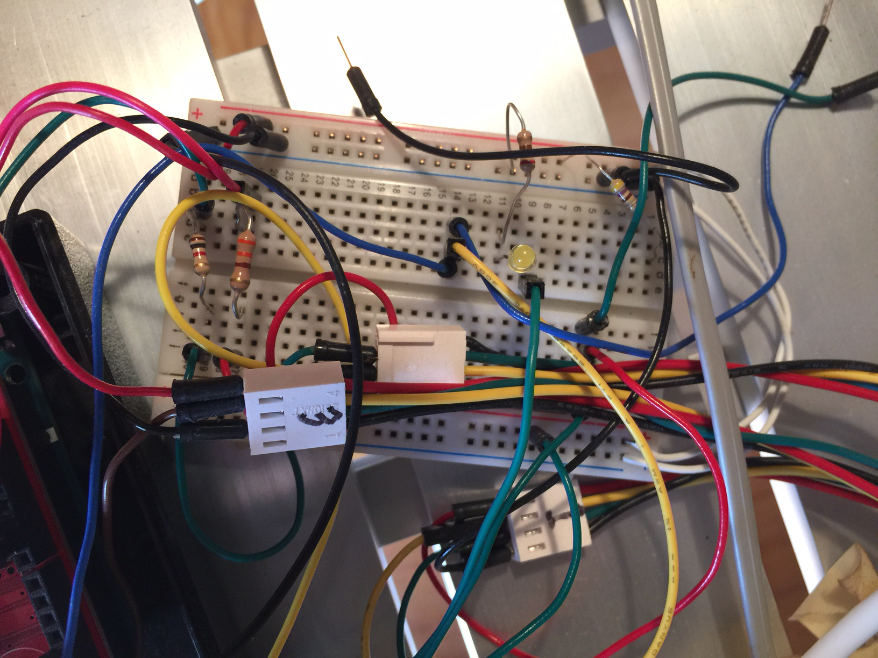
Documentation/ScopeImages/Rotation Wiring/IMG_0870.JPG
