EridaniBrew/BrewSpinDome/Documentation/ScopeImages/Rotation Wiring/IMG_0871.JPG

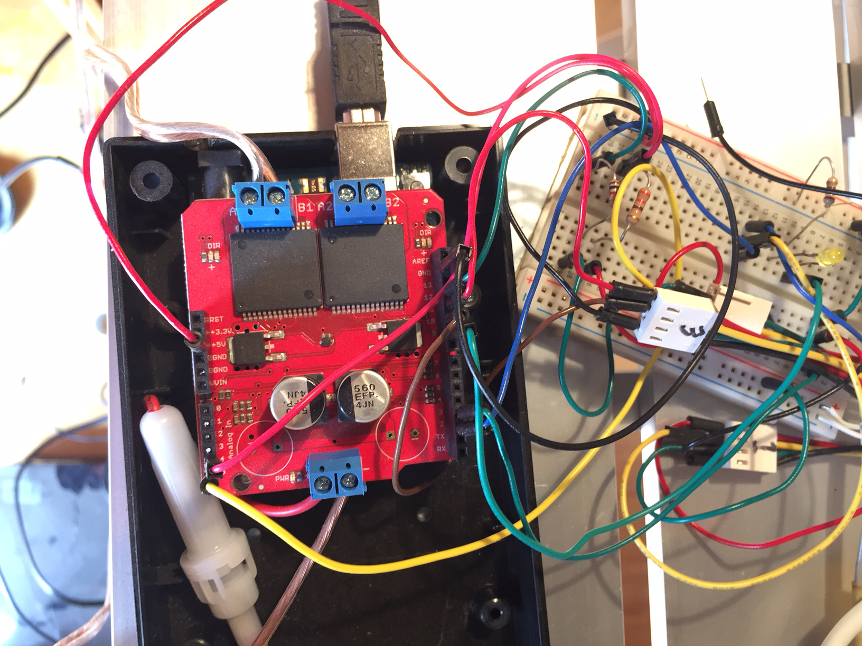
Documentation/ScopeImages/Rotation Wiring/IMG_0871.JPG
