EridaniBrew/BrewSpinDome/Documentation/ScopeImages/Rotation Wiring/IMG_0873.JPG

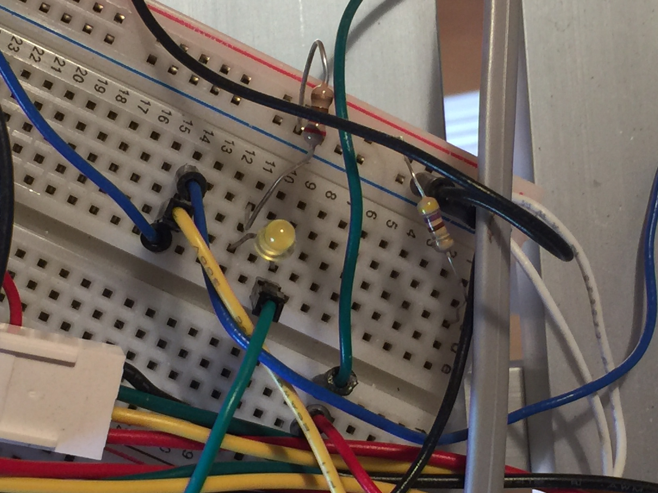
Documentation/ScopeImages/Rotation Wiring/IMG_0873.JPG
