EridaniBrew/BrewSpinDome/Documentation/ScopeImages/Rotation Wiring/IMG_0874.JPG

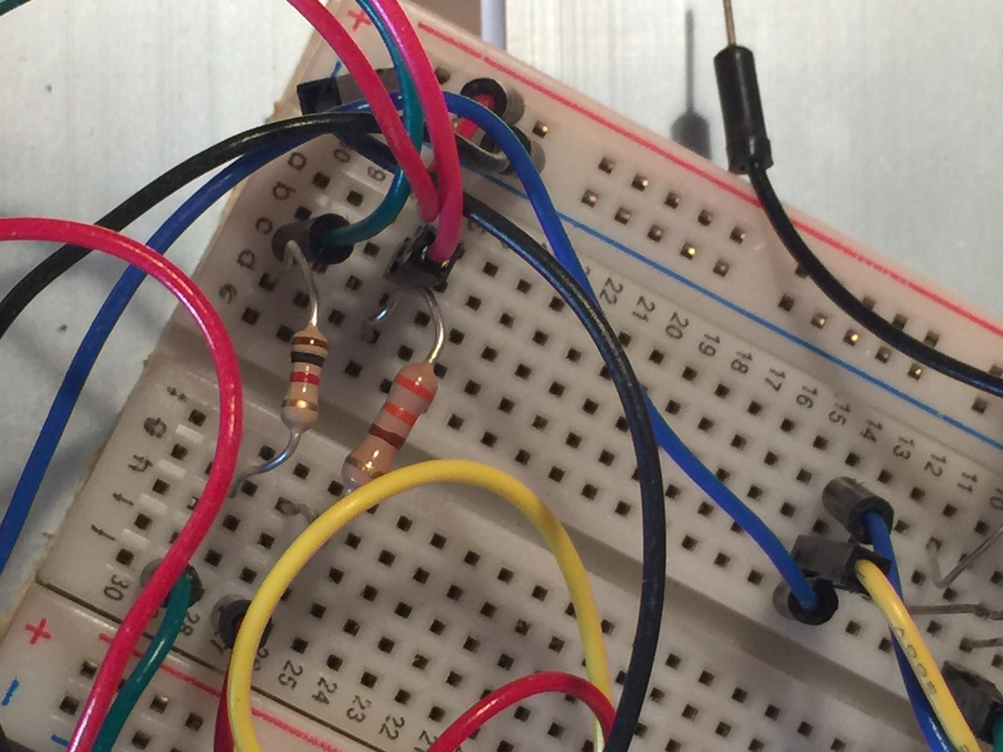
Documentation/ScopeImages/Rotation Wiring/IMG_0874.JPG
