EridaniBrew/BrewSpinDome/Documentation/ScopeImages/Rotation Wiring/IMG_0875.JPG

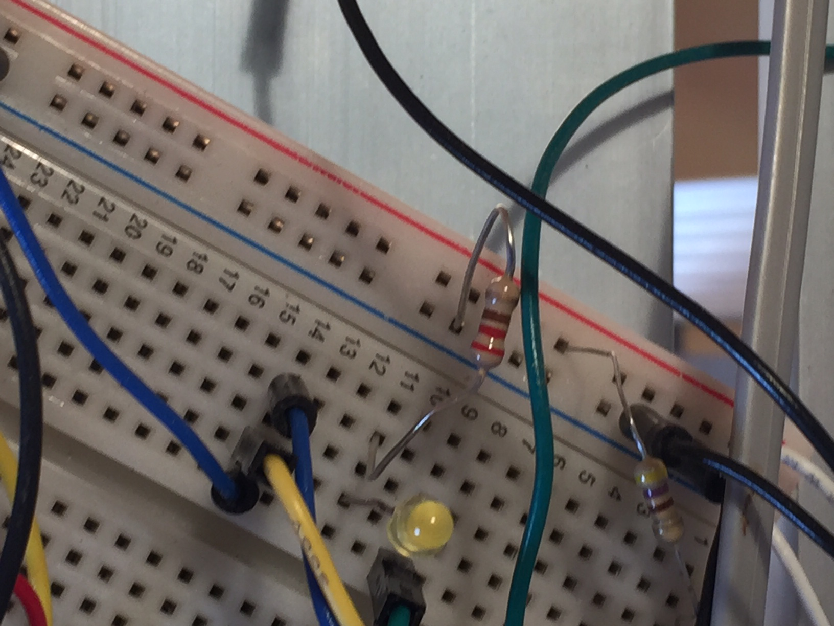
Documentation/ScopeImages/Rotation Wiring/IMG_0875.JPG
