EridaniBrew/BrewSpinDome/Documentation/ScopeImages/Rotation Wiring/IMG_0877.JPG

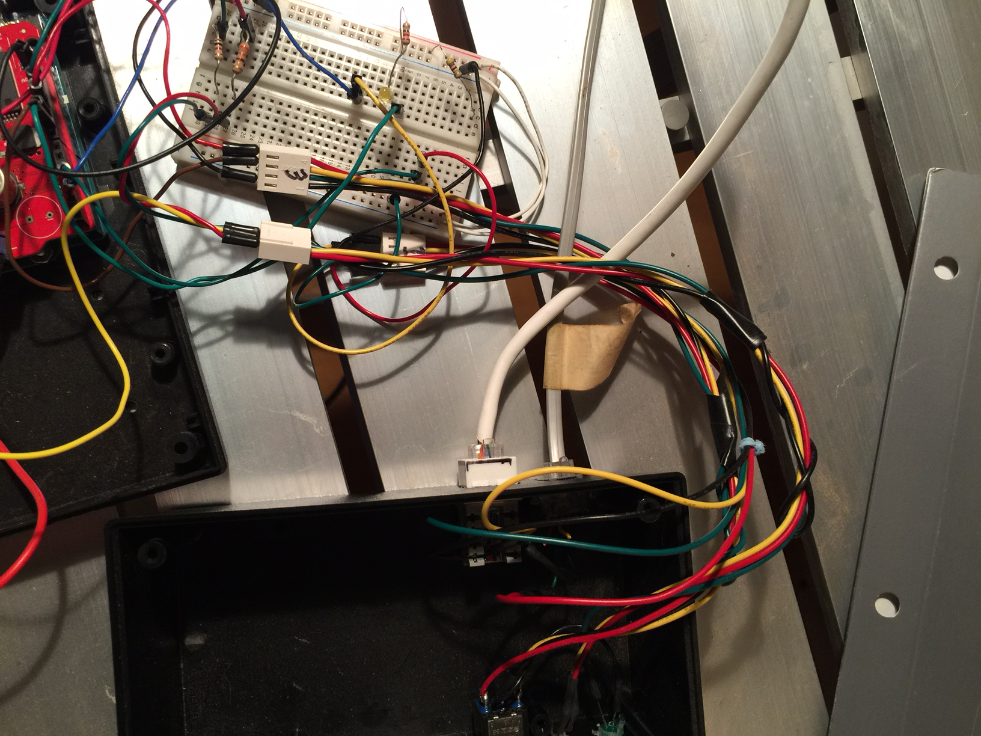
Documentation/ScopeImages/Rotation Wiring/IMG_0877.JPG
