EridaniBrew/BrewSpinDome/Documentation/ScopeImages/Rotation Wiring/IMG_0880.JPG

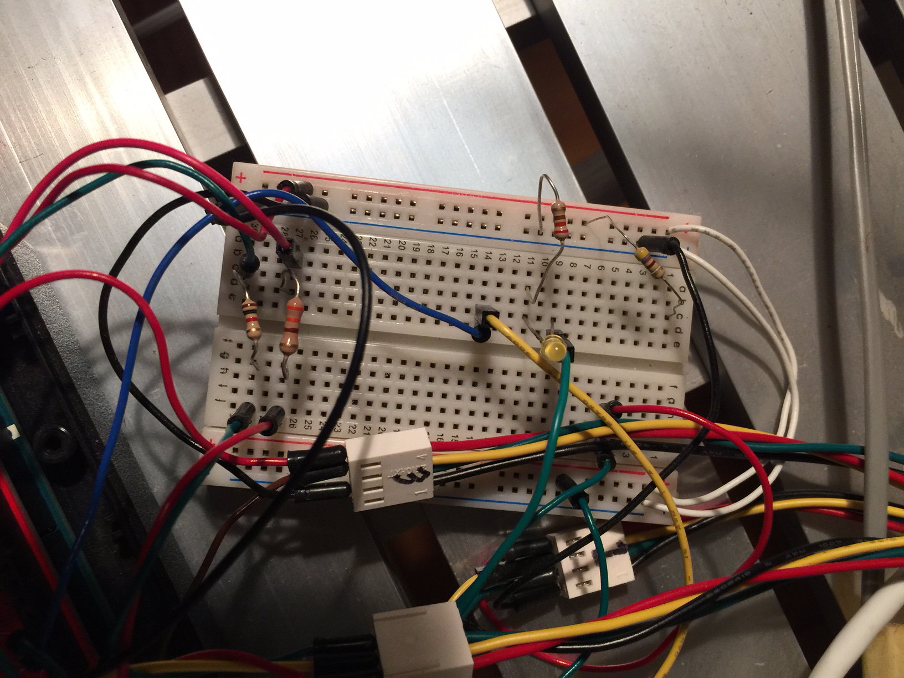
Documentation/ScopeImages/Rotation Wiring/IMG_0880.JPG
