EridaniBrew/BrewSpinDome/Documentation/ScopeImages/Rotation Wiring/IMG_0881.JPG

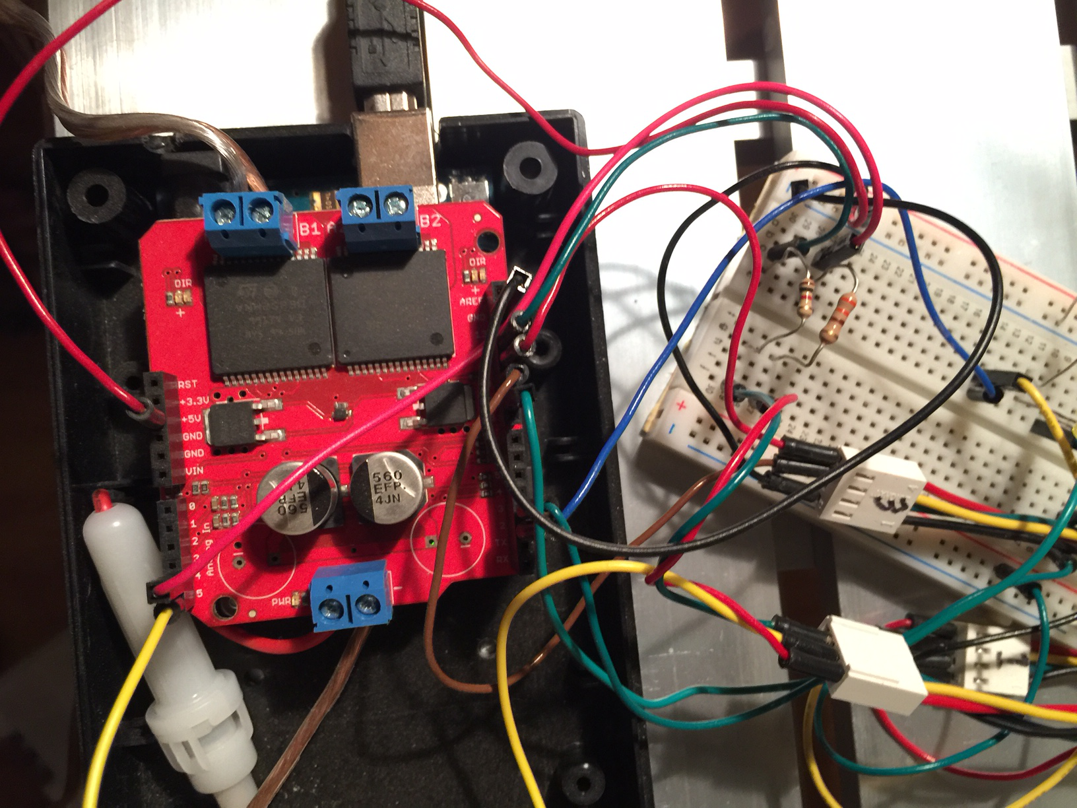
Documentation/ScopeImages/Rotation Wiring/IMG_0881.JPG
