EridaniBrew/BrewSpinDome/Documentation/Shutter/ShutterWiring.png

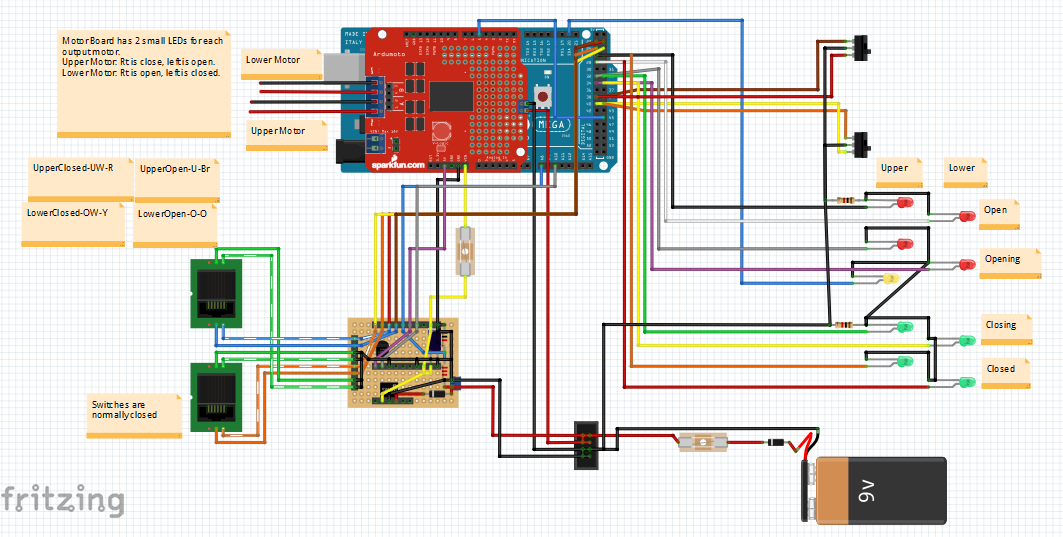
Documentation/Shutter/ShutterWiring.png
