EridaniBrew/BrewSpinDome/Documentation/SpinDomeWiringPlan.png

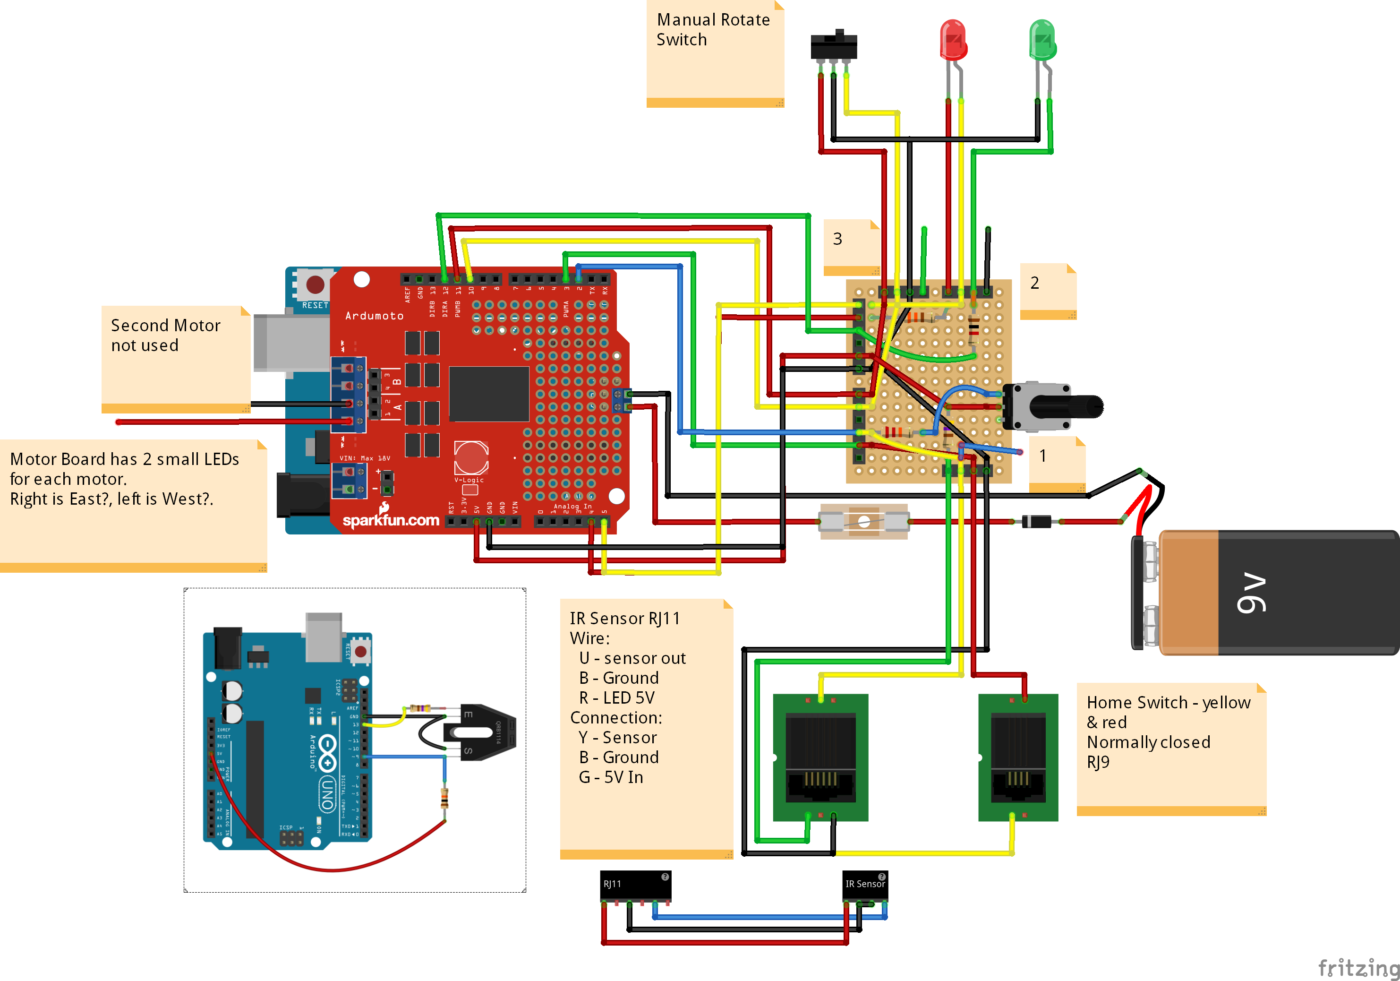
Documentation/SpinDomeWiringPlan.png
