EridaniBrew/BrewSpinDome/Documentation/SpinDomeWiringPlan_bb.png

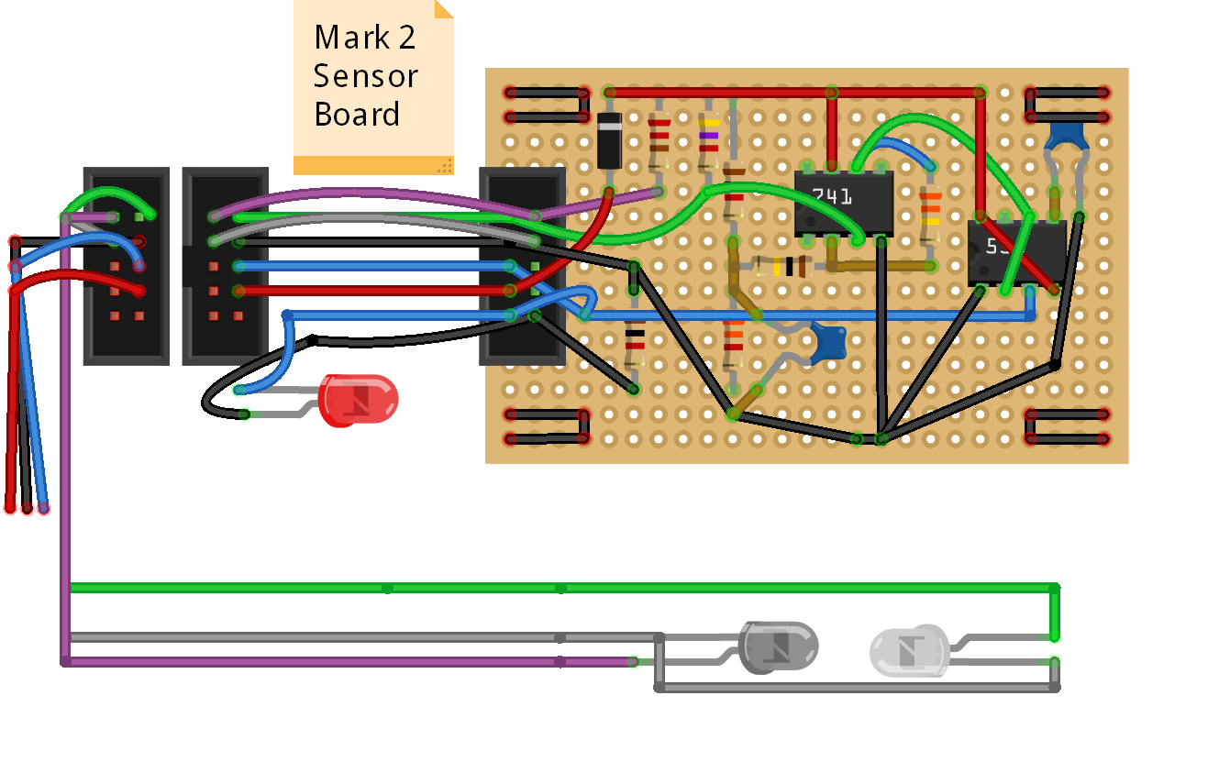
Documentation/SpinDomeWiringPlan_bb.png
