EridaniBrew/BrewSpinDome/Documentation/SpinDomeWiringPlanMainBoard.jpg

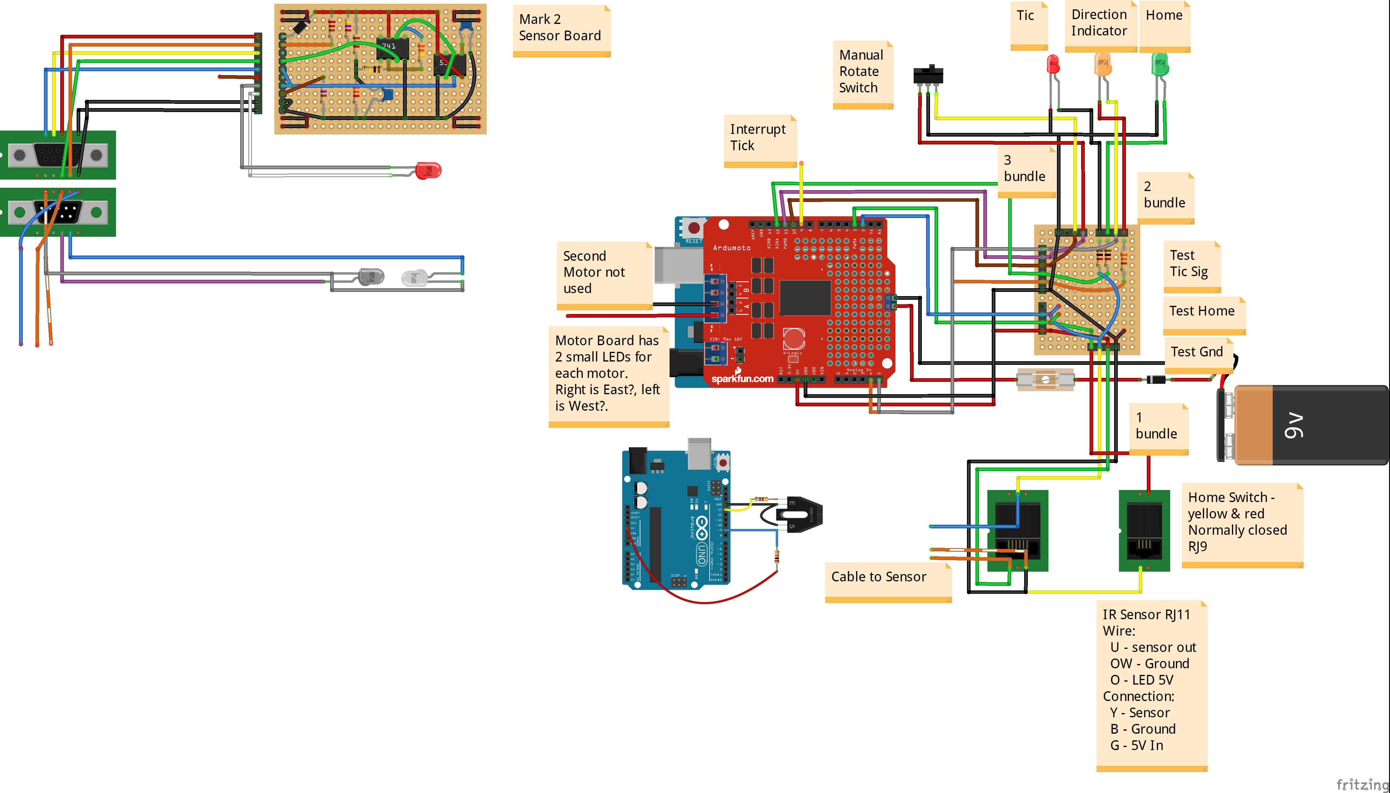
Documentation/SpinDomeWiringPlanMainBoard.jpg
