EridaniBrew/BrewSpinDome/(list of files, drawings)

Other design files:
ArduinoShutterControl/Schematic.fzz
ArduinoShutterControl/WiringSwitches.fzz
Documentation/Shutter/Schematic.fzz
Documentation/SpinDomeSchematic.fzz
Documentation/SpinDomeWiringPlan.fzz
Documentation/WiringPlan.fzz
